chootka/sLLM/documentation/exhibit_object.md

# Exhibition object — WYSIWYG

The piece as a thing that ships: a sealed Raspberry Pi and touch screen
playing one recorded run of the organism. Written 2026-09-02, touch panel and
hardware settled 2026-09-01.

## Plain English

The artwork is a circuit that a slime mould plays. The organism itself cannot
be sold or shipped, and neither can the rig it grew in, so what the buyer
receives is the instrument and one full day of the organism's activity, frozen
into a file. Plug it in and it plays that day, in real time, forever, from the
hours before the organism reached the first electrode to the hours after it was
taken out.

The screen is a touch panel, and it has exactly two things on it to touch:
one starts the sound, one opens a plain-language note about what is being
heard. Nothing else responds to a touch.

Nothing in the box is alive and nothing in the box needs a network.

## What ships

| | |
|---|---|
| form | sealed unit: Raspberry Pi 4, touch panel, DAC to stereo out, enclosure |
| behaviour | powers on, boots into the piece. Two touch targets, nothing else |
| touch | `SOUND ON/OFF` top right, `SOUND LOG` top left. 56 px minimum targets |
| content | `exhibit/object/` -- page, worklet, recording, synth, static server |
| audio | a node process, not the browser. See below |
| size on disk | 4.0 MB |
| network | none required at any point |
| writes | none at runtime |

## The recording that ships

Run 8, exported by `scripts/export_replay.py` from the electrode CSVs. The
signal chain runs once at export time; the object replays the result.

| | |
|---|---|
| length | 62.5 h |
| loop | 5.2 hours, one pass, at `?speed=12` |
| ch0 | 33.6% |
| ch1 | 77.5% |
| ch2 | 35.1% |
| file | `exhibit/replay.json`, 3.4 MB, signal per second, gate as index runs, period per minute |

Three windows end to end, all of them recordings in which the organism was in
the dish:

| | window | what happens |
|---|---|---|
| A | 2026-08-24 05:00 - 08-25 00:35, 19.6 h | silence, then ch1 arrives at h+9.4 |
| B | 2026-08-25 06:05 - 08-26 04:00, 21.9 h | ch1 and ch2 both driving |
| C | 2026-08-28 03:00 - 08-29 00:00, 21.0 h | ch0 driving, ch1 in and out |

What a listener passes through, in loop time: nine hours of three uncoupled
voices with nothing on any electrode, a first pin arriving, ten hours of one
voice pulling, a second pin arriving and the ring beginning to couple, twenty
hours of both, then the pair falling away as a different electrode picks up and
carries the last twenty hours on its own. Then it begins again.

**Why these three and not the whole record.** Every window in which the rig was
handled is left out -- the lid coming off on 2026-08-26 at 04:05, the camera
ribbon being reseated, both `sllm-api` restarts. Those register as several mV
against a 1.7 mV baseline and would be the loudest events in the piece, and
they are the sound of a person, not an organism. Segment A stops and B resumes
around 2026-08-25 00:35-06:05 for a different reason: ch0 gates there, and ch0
was never colonised in run 6, so those are the cross-talk false positives
`signal_processing.md` documents. Sonifying them would drive a vactrol from a
connection that did not exist.

The joins land on gate changes, so they read as a pin arriving or dropping
rather than as an edit.

## Touch

The object has no pointer, no keyboard and no one to help a visitor who gets
lost, so the page behaves differently when it is running as the object than it
does on the website. `Drift.vue` decides which it is from the presence of the
bundled recording -- the thing that is actually true about the object -- rather
than from a flag on the kiosk URL that could be left off. `?kiosk=1` forces
that behaviour on a laptop for previewing.

| | website | object |
|---|---|---|
| tap the field | toggles fullscreen | does nothing |
| back to the dashboard | present | not rendered |
| cursor | arrow | hidden |
| target size | 27 px | 56 px minimum, larger type |

Three of those are load-bearing:

- **A tap on the field must not toggle fullscreen.** Under kiosk the object is
  already fullscreen, so the only thing a stray tap could do is take it *out*,
  and nothing in the box could put it back.
- **The dashboard link has to go.** There is no API behind it on the object, so
  a tap in the corner would strand a visitor on a broken page with no route
  home.
- **Targets are sized for a finger.** The web sizes are 27 px tall and rely on
  `:hover`, which never fires on glass. The touch sizes are keyed to
  `@media (pointer: coarse)`, so they follow the input device rather than
  object mode, and `:active` gives the only feedback a finger gets that the tap
  landed.

The field also sets `touch-action: manipulation` and suppresses text selection,
the long-press callout and the tap highlight. Without those a finger gets
double-tap zoom, a selection drag across the field, and a context menu, none of
which a sealed object can recover from.

**The object boots silent, by design.** Sound starts on the first touch of
`SOUND ON`, not at power-on. Two consequences to weigh before a show: a visitor
who turns the sound off leaves it off for the next person, and an untouched
object reads as a still image rather than a piece with sound. If either matters
at a given venue, the fixes are an autostart on load and an idle timer that
restores sound and closes the log. Neither is built.

## How the sound is shaped

Settled 2026-09-03. Circuit fidelity is no longer the tiebreaker for this
object -- these are aesthetic choices, judged by ear. What stays fixed is that
the sound follows the recording: nothing here is keyed to anything but the data.

- **The bed and the foreground.** With no pin connected there is no bio signal,
  only the oscillators idling, and hours of that at full brightness is
  genuinely wearing -- nauseating, in the artist's word. The piece now rests as
  a pad and comes forward when the organism reaches an electrode. The swell is
  keyed to the vactrol drive, so it follows whatever the data does rather than
  any assumption about which pin connects when.
- **Measure contact above the free-run floor.** The drive rests at 0.12, not 0.
  Keying the swell to the raw value made "rest" compute a third of the way
  open, and every attempt to tune the bed fought that instead of the sound.
- **The pad comes from the capacitor node, not the comparator.** A 40106's
  output is a hard square: instantaneous edges, which alias at 48 kHz, and
  aliased partials fold down *below* the cutoff where no filter reaches them.
  That inharmonic content is why filtering only ever made the bed duller
  without making it smoother. The capacitor voltage ramps between the two
  Schmitt thresholds -- a triangle, with almost nothing to alias. Some square
  blends back as contact arrives, where the bite belongs.
- **Register: `capScale` is 1.0, not 2.13.** At 2.13 the bank runs at 35-67 Hz.
  That was audible only because a square's harmonics reach into the hundreds of
  Hz; once the triangle and the low-pass removed them, 94% of the output energy
  sat below 60 Hz and the piece went silent on ordinary speakers. Measured, not
  guessed -- and the trap is that RMS still reads healthy, so it is possible to
  make the piece twice as loud and completely inaudible at the same time.
  **Check where the energy is, not just how much.** Render offline and look:

        node synth.js --wav /tmp/t.wav --secs 8 --speed 12

- **Levels live in `synth.js`, not the worklet.** The host posts `gain`, `vco`,
  `mix` and `capScale` at startup and they overwrite the processor's own
  defaults. Editing the constructor alone does nothing.
- **A brown-noise layer was tried and removed.** Brown noise is road noise --
  it read as scrapy, then noisy, then "inside a car on the freeway". Left wired
  at zero (`NOISE_LEVEL`) in case a trace sits well under a fuller pad later.
- **Long vactrol tails.** 5 ms rise and 50 ms fall passed every wobble in the
  data straight to pitch, which is what made this restless rather than
  hypnotic. 50 ms/600 ms is both calmer and closer to a real LDR.
- **The bed is stereo.** Fading the PLL in with contact left the right channel
  silent between connections -- half the piece missing on a stereo pair, and
  most of why it once seemed too quiet. The split still means something where
  it matters: the left keeps the oscillators, the right hands over to the PLL.
- **The bloom and the swell are one gesture.** `FLASH_MS` in `Drift.vue` and
  `SWELL_UP` in `ring-processor.js` are both 1.5 s on purpose: the yellow
  travels out from the pin over exactly the time the sound takes to come
  forward. Change one and change the other, or they read as two events that
  happen to coincide.
- **Sound off puts the field in standby.** The synth keeps running, but nothing
  drives the picture, so only the slow rotation remains and blooms are
  suppressed. The object rests until a visitor starts it.

The numbers to turn, all at the top of `ring-processor.js`: `REST_LEVEL` how
far back the bed sits, `FC_BED` muffled versus piercing, `BED_DRIVE` thickness,
`TRI_FWD` how much bite the foreground keeps, `SWELL_UP`/`SWELL_DN` how it
arrives and leaves, `BED_DROP` bed register.

## The audio does not run in the browser

Chromium on this Pi cannot hold an audio stream. This was established by
bisection, not inference:

- A native `OscillatorNode` -- no JavaScript anywhere in the audio path --
  drives the ALSA device into repeated `XRUN` and `SETUP` exactly as the piece
  does. So does a worklet emitting pure zeros.
- `aplay` writing a five-minute tone to the same DAC is clean throughout.
- It ignores `/etc/asound.conf` and `PULSE_SERVER` and takes the hardware
  directly, so it cannot be moved onto a gentler path.

`SETUP` is the device being closed and reopened, and that reopen is what was
audible as clicking.

So `exhibit/synth/synth.js` runs the audio instead. It loads the **same**
`ring-processor.js` against the **same** `replay.json` and pipes PCM into
`aplay`. The worklet is never copied -- one file, so the browser and the object
cannot drift into two different instruments.

It publishes its state over Server-Sent Events on port 8081, and the page reads
that instead of running an `AudioContext`: oscillator frequencies, coherence,
mux address, drives, gates, and the pin-connect flashes. Audio and image now
come off one clock rather than two, which is better sync than the browser
version had. `SOUND ON` becomes a request to the synth.

Absent the synth, the page falls back to its own worklet unchanged, so
`sllm.visceral.systems/drift` is untouched by any of this.

**Feeding aplay correctly is the whole trick**, and getting it wrong sounds
exactly like the browser problem it replaced:

- Write in chunks. 128-frame blocks are 512 bytes and thousands of syscalls a
  second; 32 blocks is 85 ms per write.
- Let the pipe pace it. An extra wall-clock throttle stops the feed while the
  pipe would still take more, and aplay starves.
- Give aplay a buffer. `--buffer-size=32768` is 680 ms to coast on; the default
  is far too small.

Underruns are the symptom, and they are visible:

    journalctl -u drift-synth --since "10 min ago" | grep -c underrun

Zero is correct. Anything else and the piece is blipping.

## Build

    # three windows, then joined end to end
    ./scripts/py scripts/export_replay.py --start '2026-08-24 05:00:00' \
        --end '2026-08-25 00:35:00' --out /tmp/seg_A.json
    ./scripts/py scripts/export_replay.py --start '2026-08-25 06:05:00' \
        --end '2026-08-26 04:00:00' --out /tmp/seg_B.json
    ./scripts/py scripts/export_replay.py --start '2026-08-28 03:00:00' \
        --end '2026-08-29 00:00:00' --out /tmp/seg_C.json
    ./scripts/py scripts/splice_replay.py /tmp/seg_A.json /tmp/seg_B.json \
        /tmp/seg_C.json --out exhibit/replay.json --note '...'
    ./exhibit/build.sh                      # -> exhibit/object/
    python3 exhibit/object/serve.py 8080    # test at /drift

`replay.json` is checked for shape, not for status code, so a server that
answers every path with `index.html` cannot fool the page into thinking it has
a recording. With no `replay.json` present the same build runs live against the
API, which is what `sllm.visceral.systems/drift` does.

## On the object

1. Copy `exhibit/object/` to `/home/chootka/drift` on the Pi.
2. All three units to `/etc/systemd/system/`, then enable:

        sudo cp exhibit/drift-server.service exhibit/drift-synth.service \
                exhibit/drift-kiosk.service /etc/systemd/system/
        sudo systemctl daemon-reload
        sudo systemctl enable --now seatd drift-server drift-synth drift-kiosk

   `drift-synth` runs under `SCHED_FIFO` -- the real-time priority chromium
   never had. Priority 10, not 99: enough to beat the renderer, low enough that
   a runaway loop cannot lock the machine out of ssh.

3. Stop getty owning the console, or cage can never take it:

        sudo systemctl disable --now getty@tty1

   Without this the kiosk unit starts, exits cleanly with no error output, and
   restarts forever while the display sits on a login prompt.
4. Screen blanking off (`sudo raspi-config nonint do_blanking 1`), and set the
   timezone (`sudo timedatectl set-timezone Europe/Berlin`) -- the panel prints
   the recording's date in the object's own timezone.
5. Set the volume and store it. There are no controls on a sealed object, so
   whatever is stored is what the buyer gets on power-up. `Digital` at 85% was
   right on the HiFiBerry DAC+ Pro with powered speakers:

        amixer -c 0 sset Digital 85%
        sudo alsactl store
6. Check it survives a power cut, which is the thing a buyer will actually do:
   `sudo reboot`, and the piece should come back on its own with sound
   available on the first touch.
5. Make the DAC the default ALSA output and prove it before sealing: `aplay -l`
   to find the card, set it in `/etc/asound.conf`, then `speaker-test -c2
   -twav` to hear both channels come out of the actual speakers.
6. Touch the two buttons on the assembled object before it ships. Everything
   above can be right while the panel is still delivering no touch events.

Every flag in `drift-kiosk.desktop` is there for a reason, and the reasons are
written in the file itself. The four that will cost a show if they are dropped:

- `--autoplay-policy=no-user-gesture-required`. The visitor's touch on
  `SOUND ON` is a real gesture, so this is belt and braces rather than the only
  thing holding the sound up -- but Chromium can still refuse a first
  AudioContext on a page it thinks has had no genuine interaction, and the
  failure mode is a piece that looks fine and makes no sound.
- `--disable-session-crashed-bubble` and `--restore-last-session=false`. The
  buyer unplugs it; without these the next boot puts a "Chromium didn't shut
  down correctly" bar across the top of the artwork, and there is no keyboard
  in the box to dismiss it.
- `--disable-pinch` and `--overscroll-history-navigation=0`. A two-finger
  stray zooms the field, and a horizontal swipe navigates the page away.
- `--check-for-update-interval=31536000`. A Chromium update prompt over the
  field is the one piece of platform infrastructure the work does not need.

## Raspberry Pi OS Lite

The object runs Lite, which ships no browser, no display server and no audio.
Three packages cover it:

    sudo apt install -y chromium cage seatd pipewire pipewire-pulse wireplumber
    sudo systemctl enable --now seatd
    sudo usermod -aG _seatd,video,input,render chootka   # then log out and in

`cage` is a kiosk Wayland compositor: it runs one fullscreen app straight from
a TTY with no desktop behind it. `seatd` is what lets it take a seat when the
session is not on the physical console -- without it cage fails with
"Could not open target tty: Permission denied", and the `_seatd` group does not
exist until the package is installed.

Trixie calls the browser `chromium`, not `chromium-browser`. Running it by
hand, to check before enabling autostart:

    python3 ~/sLLM/exhibit/object/serve.py 8080 &
    cage -- chromium --kiosk --autoplay-policy=no-user-gesture-required \
        'http://127.0.0.1:8080/drift?speed=12'

Autostart is `exhibit/drift-kiosk.service`, which replaced the old
`drift-kiosk.desktop` -- Lite has no desktop session and no `~/.config/autostart`
to put a .desktop file in. It runs cage on tty1 through a real login session,
which is what lets it take seat0.

## Hardware

Settled 2026-09-01: **Raspberry Pi 4, touch panel, DAC for audio out.** Still
to be confirmed against the parts once they are in hand.

- **The DAC overlay must be `hifiberry-dacplus-std`.** Not `-pro`, and not
  plain `hifiberry-dacplus`. The board is an Innomaker PCM5122 HAT, 384 kHz/
  32-bit, with its own dual oscillators. The `snd_rpi_hifiberry_dacplus` driver
  auto-detects that Pro hardware and takes the board as clock master, then
  divides HiFiBerry's 22.5792/24.576 MHz crystals to get the sample rate.
  Innomaker fitted a different pair, so the driver programmed a divider for
  48000 and the card emitted 96000: **exactly double, and invisible to every
  layer above it.** `hw_params` reported `rate: 48000` throughout. `-std`
  forces the Pi to supply the clock and the rate comes out right.

  **The tell is the card name.** `aplay -l` must read `HiFiBerry DAC+`. If it
  reads `HiFiBerry DAC+ Pro`, the driver is dividing the wrong crystals and
  everything below follows. Note that plain `hifiberry-dacplus` also
  auto-detects Pro -- only `-std` reliably suppresses it.

  **The test, which takes fifteen seconds** (found 2026-09-03):

        head -c 1920000 /dev/zero > ~/10s.raw   # ten seconds at 48k stereo
        time aplay -D plughw:0,0 -f S16_LE -r 48000 -c 2 -t raw ~/10s.raw

  Must return ~10 s. It returned 5.09 s under `-pro`, reproducible to 4 ms.
  Re-run it after any change to the audio hardware, kernel, or OS image.

  What the doubling caused, none of which pointed at a clock: audio an octave
  high (the "chipmunk voice", which was never actually fixed, only lived with);
  `aplay` draining the synth's stream at 2x realtime so generated audio outran
  the wall clock a second per second; the state timeline hitting its 4000-entry
  cap after ~2.5 minutes and discarding the snapshots that matched audible
  audio; and the visuals desyncing from the sound at that exact moment, every
  run. Hours went into the desync as a software problem before the byte counter
  in `synth.js` and the `aplay` timing test located it in the hardware.

  Dead ends, recorded so they are not re-run: the ALSA software path (`hw:0,0`
  times identically to `plughw:0,0`), HAT EEPROM auto-configuration
  (`/proc/device-tree/hat/` does not exist on this board), short input files,
  and buffering (`buffer_size` is 24000 frames, half a second, far too small to
  explain a five-second discrepancy).
- **Audio out.** The DAC decides this, not the Pi. A Pi 4 does have the 3.5 mm
  jack, but the DAC is the better path and it has to be made the *default*
  ALSA device -- Chromium plays to whatever ALSA hands it, so a DAC that is
  present but not default is a silent object with no error anywhere to explain
  it.
- **Screen.** Any HDMI or DSI touch panel. The field is a character grid and
  rescales to whatever it is given. Confirm the panel reports as a touch device
  to Chromium; `--touch-events=enabled` in the launcher forces it on for the
  case where the panel enumerates after the browser starts.
- **Power cycling.** The buyer will unplug it. The launcher now suppresses the
  "Chromium didn't shut down correctly" restore bar, which would otherwise sit
  across the top of the artwork with no keyboard to dismiss it. A read-only
  overlay filesystem is still worth doing; nothing at runtime writes to disk.
- **Stereo, not mono.** The three oscillator voices come out of the left
  channel and the PLL out of the right. Measured on the built object: left peak
  0.25, right 0.04. The sound log describes that split to the viewer in so many
  words, so a mono DAC or a single speaker makes the piece contradict its own
  wall text.

## Playback

`?speed=` on the kiosk URL timelapses the file without a rebuild, and the
shipped kiosk URL carries `?speed=12`, which plays the 62.5 h in 5.2 hours.
Drop the parameter and the same file runs in real time, which is two and a half
days a pass.

5.2 hours is chosen so that nobody in a gallery hears it repeat, and so that
whoever owns it keeps finding parts of it they have not heard. The panel's first line states which is running.

The date on that line is rendered in the *viewer's* timezone, so it reads
"August 28" on a Pi set to CEST and "August 27" on a machine in the Americas.
Set the object's timezone before it ships.

**`speed` does not mean the same thing on the website as it does here**, and
the two differ by a factor of five for this window. `advance()` steps `speed`
*array indices* per second, and the arrays are built differently:

| | array | one index is | `speed=12` gives |
|---|---|---|---|
| website | `buckets = min(2000, span)` from the API | 5.4 s of record, for a 3 h window | ~65x real time, a pass every 2.8 min |
| object | `replay.json`, 1 Hz | 1 s of record, always | a true 12x, a pass every 15 min |

So a `speed` that sounded right on `sllm.visceral.systems/drift` is not the
same tempo once the window is frozen, and the object's is the honest one --
the label's "15 minutes" is true here and wrong on the website, where the
bucketing is not accounted for. 12 was chosen on the object after hearing both.

## Not in the box

No organism, no agar, no electrodes, no rig. The work is the instrument and the
record. The organism this record came from was removed from the dish on
2026-08-29 and is not part of the sale.

## Draft listing

**Title.** drift — a slime mould plays a CMOS circuit (sealed player, 5-hour cycle)

**Spec.**

- Sealed player: Raspberry Pi, touch screen, stereo audio out. Plug in and it
  runs. Two things to touch: one starts the sound, one explains what you are
  hearing.
- Plays 62.5 hours of recorded *Physarum polycephalum* activity on a 5-hour cycle.
- Sound and image are generated live from that recording by a software model of
  a CMOS oscillator circuit, not video playback.
- No network, no account, no app, no writes. It runs the same in fifty years as
  it does now, given power.

**Description.** Three metal electrodes sit in agar in a covered dish. A slime
mould is placed on a fourth and grows outward. When it reaches an electrode, a
voltage appears there that rises and falls about every two minutes. This was
recorded once a second for a day and a night, from before the organism arrived
at the first electrode to after it was taken out.

Those measurements drive three oscillators wired in a circle, each leaning on
the next. Pushed hard they collapse into one note; released they slide apart
and beat. The picture is the same three oscillators drawn as interference
rings. It is not a rendering of the data; it is the data pushing a circuit
around.

The recording is dated and specific: 62.5 hours drawn from late August 2026.
It opens before the organism has reached anything, and over the cycle two
electrodes are reached, held, and lost, and a third picks up. Five hours of
playing time, then it begins again.
