chootka/sLLM/documentation/archive/session_20260824.md

# 2026-08-24 — steps 1-4 closed, live run started

Session: 2026-08-24, 01:34-03:00 CEST (Pi clock, Europe/Berlin).
All timestamps in this document are CEST unless marked otherwise.

## Step 1 — shorted-lead test. DONE

*Recorded 2026-08-24 01:34:49-02:01 CEST.*

Four rows tied with wire scraps (r38L, r38R, r40L, r40R). Resistor legs are
trimmed flush; nothing to clip. Recorded 27 min, 1511 samples, 8 SPS.

| | shorted | settled beaker |
|---|---|---|
| ch0 | -1.72 | -3.71 |
| ch1 | -1.45 | -3.77 |
| ch2 | -2.32 | -4.01 |

Drift over 27 min: ch0 +0.025, ch1 +0.004, ch2 +0.031 mV. Flat.

Electrode contribution (beaker minus shorted): ch0 -1.99, ch1 -2.32, ch2 -1.69 mV.

Inter-channel spread is smaller in solution than shorted (ch2-ch0: -0.600 shorted,
-0.299 in beaker). Electrode offsets partly cancel op-amp offsets.

Offsets do not matter: stable to 0.053 mV across the settled hours, and the
buffers are unity gain so amplitudes stay comparable between channels.

**Withdrawn:** the "ch2 wanders 2.7 mV / 20 min" claim. It came from a 20 min
window taken ~50 min after immersion, inside the settling transient. The 26 h
beaker record (78,609 samples, 2026-08-22 02:00 -> 2026-08-23 04:04) shows all
three converging to within 0.35 mV and flattening. No re-plating.

Method: do not attribute drift from a window shorter than the settling time.

## Step 2 — foil shield. OPTIONAL, not indicated

*Decided 2026-08-24 ~02:15 CEST, from data of 2026-08-22/23 and 2026-08-24.*

High-frequency noise, sample-to-sample, drift-immune:

| | shorted | in beaker |
|---|---|---|
| ch0 | 0.037 | 0.026 mV |
| ch1 | 0.020 | 0.026 mV |
| ch2 | 0.182 | 0.060 mV |

In-solution noise is at or below the shorted floor, so the chamber is not
picking up. No day/night pattern across 26 h (ch2 0.040-0.096 mV). ADS1115 at
8 SPS already notches 50/60 Hz.

ch2's excess noise belongs to the wire-scrap tie, not the channel.

## Steps 3-4 — agar islands. DONE

*Built 2026-08-24 ~02:15-02:40 CEST.*

Four non-nutrient 2% islands, bare dish floor between, 150 mm arena.

| | diameter | height |
|---|---|---|
| reference, centre | 20 mm | 4 mm |
| recording x3 | 15 mm | 4 mm |

10 mm bare floor edge-to-edge. Centre-to-recorder 27.5 mm.

As built: two recording islands 10 mm from each other and from the reference;
the third 10 mm from the reference only. Acceptable — each channel is E - REF,
so the reference distance is what sets it. The close pair is a short-baseline
comparison.

Tips flat on the dish floor at one depth, agar dropped over them. Oat flake on
the three recording islands, none on the reference.

**Expected period is 30-40 min, not 60-200 s.** 27.5 mm spacing is the 2-3 cm
band (Adamatzky and Jones 2011). The 60-180 s figure (Kishimoto 1958) needs
2-3 mm spacing, which is incompatible with 10 mm gaps. Gaps kept: the chamber
runs 95-97% RH and condensation bridges narrow bare plastic.

## Order changed

Organism was inoculated before step 5 (12 h blank noise floor). Not reversed.
Step 5 is dropped; step 7 (post-removal blank) extends from 6 h to 12 h and
serves as the only blank. Interpretation now happens before the control instead
of after.

## Run state

*As of 2026-08-24 02:42 CEST.*

- `20260824T004220Z-live` started 02:42 CEST, writing
  `data/readings/electrodes_20260824.csv`
- Recovery mode ON — panel dark, blue/red LEDs blocked, `sllm-loop` held off
- Timelapse running, 300 s interval
- 24 h counts from when a tube bridges to a recording island, 36 h max
- Then: organism out, `test` mode, 12 h blank

## Notes

- `data/readings/test/electrodes_20260823.csv` carries 2071 NUL bytes from the
  unclean shutdown at 2026-08-23 04:04. Three lines lost of 77,479. Skip lines
  containing NUL when parsing.
- Admin `POST /api/admin/run` returns 401 when not logged in. The mode switch
  silently does not take.

## For the paper

Rationale and citations: `method_basis.md`.

### Methods as built, as of 2026-08-24

Instrumentation. Four Ag/AgCl electrodes, tips chloridized electrolytically over
5 mm. One MCP604 CMOS quad op-amp as unity-gain follower per electrode, VDD 3V3,
inputs biased to 1.65 V through 10 MΩ. 10 kΩ + 100 nF at each ADC pin, low-pass
159 Hz. ADS1115 16-bit ADC at 8 SPS, which notches 50 and 60 Hz. Recorded
differentially as E - REF, three channels against one shared reference. Raspberry
Pi 5. Electrodes enter on shielded Cat6 through a sealed grommet with a drip
loop; shield grounded at the board only, never inside the chamber.

Arena. 150 mm Petri dish in a plain plastic chamber, 25 C, 95-97% RH. Four
islands of non-nutrient 2% agar on the bare dish floor: reference 20 mm dia x
4 mm, three recording islands 15 mm dia x 4 mm, 10 mm of bare floor edge to
edge, 27.5 mm centre to centre. All four tips laid flat on the dish floor at one
depth and agar dropped over them. Bare oat flake on each recording island, none
on the reference. Plasmodium inoculated on the reference island. LEDs off, panel
held dark, timelapse at 300 s.

Departures from Adamatzky and Jones 2011: 150 mm arena rather than 90 mm; three
recording electrodes rather than up to eight; discrete islands separated by
10 mm of bare floor rather than blobs at unstated spacing.

### Instrument characterization — citable

*Measured 2026-08-24 01:34:49-02:01 CEST.*

Measured with electrodes removed and the four buffer inputs tied into one node,
27 min at 8 SPS:

| | drift over 27 min | HF noise, shorted | HF noise, in solution |
|---|---|---|---|
| ch0 | +0.025 mV | 0.037 mV | 0.026 mV |
| ch1 | +0.004 mV | 0.020 mV | 0.026 mV |
| ch2 | +0.031 mV | 0.182 mV | 0.060 mV |

HF noise is the standard deviation of the sample-to-sample difference divided by
sqrt(2), which is immune to slow drift. In-solution noise at or below the
shorted floor demonstrates the chamber picks up no significant interference; no
electrical shielding was fitted. No day/night pattern over 26 h (ch2
0.040-0.096 mV).

Fixed inter-channel offsets 0.2-0.9 mV, stable to 0.053 mV over the settled
hours. Buffers are unity gain, so amplitudes are comparable across channels.

Against the 2-5 mV amplitudes reported by Adamatzky and Jones, signal to noise
is 50-200x.

### Negative results worth reporting

1. A 20 min recording taken 50 min after immersion showed 2.7 mV of apparent
   drift on ch2. A 26 h record showed all three channels converging to within
   0.35 mV. The apparent drift was the settling transient. Drift must not be
   attributed from a window shorter than the settling time.
2. An earlier ~50 s rhythm was an artifact of common-mode subtraction against
   the shared reference, not biological. Signals appearing identically on all
   three channels indicate reference movement.
3. The continuous agar bed used previously shunts the source. Computed divider
   30:1 to 300:1; a 5 mV tube potential arrives as 17-170 µV.

### Protocol deviation this run

The 12 h blank noise floor was scheduled before inoculation. The organism was
introduced first. The blank is therefore recorded after organism removal rather
than before. Same measurement, opposite order; interpretation precedes the
control.

## Timeline, 2026-08-24 (CEST)

| time | event |
|---|---|
| 01:34 | Pi booted after power loss; API up; test run resumed |
| 01:34:49 | shorted-lead recording starts, four rows tied |
| 02:01 | shorted-lead recording ends, 27 min, 1511 samples |
| 02:08 | electrodes untied and returned to saline; handling transient in record |
| ~02:15 | foil shield marked optional; agar island build starts |
| ~02:40 | four islands built, tips placed, plasmodium inoculated on reference |
| 02:38:53 | mode switch to live rejected, HTTP 401, admin not logged in |
| 02:42:20 | live run `20260824T004220Z-live` starts recording |
| 13:24:30 | tube bridges reference to ch1 (blue). ch1 steps +18 mV vs ch0/ch2, all three step +19 mV common mode, ch1 per-sample noise falls 6x |
| 23:15:30 | second tube bridges to ch2. ch0 and ch2 step, ch1 flat. ch2 noise falls 6.5x (0.703 -> 0.108 mV) over the following 20 min. ch0 noise unchanged, so not a condensation film |

Prior record referenced: beaker settling run 2026-08-22 02:00 to 2026-08-23
04:04 CEST, 78,609 samples. Power lost 2026-08-23 04:04; Pi off until
2026-08-24 01:34.

Expected next: 24 h from tube bridge, 36 h max, then organism out and 12 h blank
in test mode. Bridge 13:24:30, so 24 h ends 2026-08-25 13:24 CEST, 36 h max 2026-08-26 01:24.

Document written 2026-08-24. `method_basis.md` written 2026-08-24.
