chootka/sLLM/documentation/archive/session_20260826.md

# Session 2026-08-26

Run `20260824T004220Z-live`, continuous since 2026-08-24 02:42 CEST. 49.4 h at
the time of writing. Hours below are relative to the first bridge,
2026-08-24 13:24:30 CEST.

Charts: https://claude.ai/code/artifact/c5d332ef-effc-4cc0-9f22-fe3fae29b3d0

## Channel map

Board A rows are the source of truth, confirmed at the bench 2026-08-26.

| ADS input | channel | Board A row | Cat6 pair | state |
|---|---|---|---|---|
| A0 | ch0 | r38L | orange | never colonised |
| A1 | ch1 | r40L | blue | bridged 08-24 13:24:30 |
| A2 | ch2 | r40R | green | bridged 08-24 23:15:30 |
| A3 | reference | r38R | brown | inoculated at t=0 |

`hardware_setup.md` had green and blue transposed ("orange E1, green E2,
blue E3"); corrected. Panel trace colour for ch0 changed from yellow (the ADS
lead colour) to orange (the Cat6 pair) in `frontend/src/App.vue` —
**source only, the deployed bundle still draws yellow until a rebuild.**

## Timeline additions

| time | event |
|---|---|
| 2026-08-26 04:05:30 - 04:07:00 CEST | lid opened, electrodes wiggled. Per-sample noise 4.1 mV (ch0), 4.8 mV (ch1). **Exclude this window from all analysis.** |
| 2026-08-26 04:07 onward | ch2 offset moved from -11.2 to -6.7 mV across the disturbance and did not return |
| as of 2026-08-26 | ch0 island still not colonised. Organism has not bridged to it. |
| 2026-08-26 ~04:14 | camera ribbon pulled while powered, then reseated. Frame sizes fell 250 kB -> 93 kB |
| 2026-08-26 04:18:36 | `Camera frontend has timed out!` in `sllm-api`. Captures stopped after 04:14:47; 04:19 and 04:24 missed |
| 2026-08-26 04:21 | raw probe: `i2ctransfer -f -y 11 w2@0x1a 0x00 0x16 r2` -> `0x07 0x08`, VCM 0x0c -> 0xf2. Sensor and focus motor both alive. I2C control pins fine, CSI data lanes not delivering |
| 2026-08-26 04:23:41 - 04:23:57 | **`sllm-api` restarted to recover the camera. 15 s gap in the electrode record.** run_id `20260824T004220Z-live` preserved, no new run started |
| 2026-08-26 04:23:46 | first frame after restart, 237 kB, sharp. Camera recovered. No hardware damage |

## Frontend

Rebuilt and deployed 2026-08-26 04:24. ch0 trace is now orange
(`#b4560e` light, `#ef9040` dark) instead of yellow. `/var/www/sllm/frontend`
carries `index-Cy_MKtRu.js`; the old `index-Tx28pMR8.js` is gone.

## Findings, technical

### 1. A 2.2-2.4 min oscillation is established on the bridged channels

Welch periodograms, 4 h Hann segments, 50% overlap. Significance from 200
coloured-noise surrogates drawn on each channel's own smoothed background
(running median, +-0.6 octave in log period).

| window | ch0 unbridged | ch1 bridged 13:24 | ch2 bridged 23:15 |
|---|---|---|---|
| blank h-10..-0.2 | 1.1 min, p 0.14 | 1.3 min, p 0.84 | 1.1 min, p 0.12 |
| plateau h+11..22 | 2.4 min, p 0.015 | 2.4 min, p <0.005 | 2.4 min, p <0.005 |
| decay h+23..end | 2.6 min, p 0.50 | 2.2 min, p <0.005 | 2.2 min, p <0.005 |
| latest h+26..38 | 2.18 min, p 0.36 | 2.22 min, p <0.005 | 2.22 min, p <0.005 |
| latest h+30..38 | 1.25 min, p 0.60 | 1.82 min, p <0.005 | 1.82 min, p <0.005 |

Amplitude, ch2: 1.05 mV at h+10, 1.81 mV at h+28, 0.67 mV at h+30..38.
Amplitude, ch1: 0.26-0.88 mV over the same span.
Period wanders 1.82-2.58 min across successive 4 h windows.

### 2. Controls passed

- **Chamber.** Temperature and humidity carry a line at 4.00 min only
  (0.0027 C, 0.0008 % RH). Nothing at 2.4 min.
- **Camera.** Timelapse interval 300.0 s. Epoch average of 132 captures at
  +-150 s: max |z| 2.7 (ch0), 1.8 (ch1), 1.4 (ch2) over 301 lags. No 300 s line
  in the ch2 spectrum (PSD ratio 0.45 to local median).
- **Shared reference.** Survives differencing. ch1-ch2 peaks 2.22 min at
  0.66 mV, excess +1.80 dex, p <0.005 at h+26..38.
- **Electrode connection.** Per-sample noise ch1 0.021-0.039 mV, ch2
  0.043-0.073 mV against 0.10-0.22 mV pre-bridge. ch0 unchanged at
  0.15-0.32 mV, consistent with it never having been bridged.

### 3. The 30-40 min band is still not established

0.23-0.47 mV against an expected 4-5 mV. 84% of post-bridge variance is common
to all three channels.

### 4. The DC excursion is the bridge transient, not the chamber

Step at each bridge, peak +28 mV at h+18/19, zero crossing at h+32/33.
Decay constants 8.6 h (ch0), 5.6 h (ch1), 6.5 h (ch2); slopes -1.4 to
-2.2 mV/h. Correlation with chamber temperature over h>10 is r = +0.04 to
+0.07; temperature rose 21.2 -> 25.2 C from h+28 to h+35 while all channels
fell. Correlation with elapsed time r = -0.88 to -0.91.

Inter-channel spread: 13 mV pre-bridge, 0.5 mV at h+24, 6.7 mV at h+35. Decay
rates differ per channel, so the cause is per-site, not the shared reference.

### 5. Literature match

`~/research/1012.1809v1.pdf`, Adamatzky and Jones, same electrode geometry
(one reference island, plasmodium inoculated on it, recording islands under
agar blobs):

- high-frequency waves 1-2 min at 2-3 mV -- this run: 2.2-2.4 min at
  0.5-1.8 mV. Match.
- Kashimoto, surface potential 5 mV at 1.5-2 min. Same family.
- main oscillation 30-40 min at 4-5 mV after an 8 h transient -- not seen.
- "potential rises from ground potential to 14 mV in 24 min, then drops to
  roughly -5 mV in around 37 min" as a site is occupied. Same shape as the DC
  excursion here, about 40x slower.

### 6. Method errors corrected this session

- **Raw band power ranked the wrong channel first.** ch0 has the highest raw
  1-2 min band power because it is the noisiest input (0.15-0.32 mV/sample
  against ch1's 0.02-0.04). Peak-above-local-background reverses the ranking
  and is the correct statistic.
- **Two band-amplitude estimators disagreed by 120x** before validation.
  Inject a known sinusoid and confirm recovery before trusting any estimator.
  Current one: 1.0 mV at 120 s -> 0.998; 0.5 at 1800 s -> 0.502; 4.0 at
  2100 s -> 4.000.
- **Phase-randomised surrogates are the wrong null** for a spectral peak; they
  preserve the periodogram exactly. Use coloured noise on the fitted
  background.
- `scripts/signal_check.py` searches PERIOD_MIN 30 s to PERIOD_MAX 240 s. That
  brackets this line, but its verdict needs a baseline file and was not used.

## Findings, plain language

A "band" is a range of rhythm speeds, the way bass and treble are ranges of
pitch. The millivolt figure is how big the voltage swing is at that speed.

1. The slime mould has reached two of the three recording islands. Those two
   electrodes show a voltage that rises and falls about every **2.2 minutes**,
   swinging up to **1.8 thousandths of a volt**. The third electrode, which the
   organism never reached, does not do this. Neither did any electrode before
   the organism arrived.
2. That rhythm is not coming from the equipment. The chamber's own rhythm is a
   different speed (4 minutes) and thousands of times smaller. The camera fires
   every 5 minutes and leaves no trace in the readings. Comparing the two
   colonised electrodes against each other, the rhythm is still there, so it is
   not one shared electrode moving everything at once.
3. The rhythm speed drifts between 1.8 and 2.6 minutes. Electronics keep near
   perfect time; living things do not. The drift is a point in favour of it
   being the organism.
4. The published work on this organism reports a fast rhythm of 1-2 minutes at
   2-3 thousandths of a volt. What is measured here is close to that.
5. The **half-hour rhythm the experiment was designed around is not there** --
   about a third of a thousandth of a volt where 4-5 was expected, roughly ten
   times too small. Only the fast rhythm is present.
6. The large swing from +28 down through zero to -6 thousandths of a volt is a
   separate thing and is not the organism's rhythm. It is the electrodes
   settling after the slime mould connected them, over about six hours per
   channel. It is not temperature: the chamber warmed up while the reading kept
   falling.

## Open

- Whether the 2.2 min line is contractile activity or electrochemistry at a
  colonised electrode. The organism-out blank in `test` mode decides it: if the
  line survives removal, it was never biological.
- The 30-40 min band, 10x under spec.
- ch0's marginal result, p 0.015 in one window and p 0.50 in the next.
- Why the DC potential relaxes past zero rather than back to its pre-bridge
  offsets.
- `rebuild_plan.md` step 5 states the artifact criterion as "a clean 60-200 s
  oscillation with no organism means artifact". The band is **correct** -- the
  signal is at 130-145 s, inside it. An earlier note calling for it to be
  restated for 30-40 min was based on the pre-2026-08-26 expectation and is
  withdrawn. Two real gaps remain:
  - "clean" is not a number. Fix the rule before running the blank, using the
    same statistics as the finding: a peak in 60-200 s exceeding local
    background by >1.0 dex at p<0.01 means artifact.
  - step 5 has never been run. Every blank used so far is the pre-bridge window
    inside run 6. That window is arguably better (same session, same chamber),
    but the plan should say so rather than leave the box unticked.
