chootka/sLLM/processing/phygraph/next.png

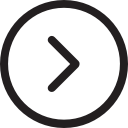
processing/phygraph/next.png
