chootka/sLLM/(commit log)

2025-11-15 Add deployment scripts for Raspberry Pi
2025-11-18 added processing, arduino scripts, updated project architecture, added dev python reqs for mac
2025-11-18 Fix Arduino reconnection logic - handle None check properly
    [app.py]
2025-11-18 Add system site-packages path for libgpiod on Raspberry Pi 5
2025-11-18 Add mock temperature/humidity data and multi-line chart with dual y-axes
    - Generate mock temp/humidity data when sensor not available
    - Update chart to show voltage, temperature, and humidity
    - Add dual y-axes (voltage on left, temp/humidity on right)
    - Fix environment thread to start even without sensor
    - Add proper chart legend and tooltips
    [app.py, config_template.py]
2025-11-18 Display voltage in millivolts (mV) instead of volts
    - Keep voltage in mV from Arduino (no conversion to V)
    - Update frontend display to show mV with 1 decimal place
    - Chart already updated to show mV
2025-11-18 Fix Flask-SocketIO production server error - add allow_unsafe_werkzeug=True
    [app.py]
2025-11-18 fixed Y axis; lighter label colors
2025-11-18 hiding light button, prep for using GPIO relay and usb module to control light; connected capture image button
2025-11-18 debuggin camera capture
2025-11-18 Make GPIO initialization more robust - handle missing relay gracefully
    [app.py]
2025-11-18 Fix image caching issue - add cache-busting headers and revoke old blob URLs
    [app.py]
2025-11-18 Update chart Y-axis range to -5 to 5 mV
2025-11-18 Fix image filename collision - add milliseconds to timestamp to prevent overwriting files
    [app.py]
2025-11-18 Fix image display: use server URLs instead of blob URLs, listen to socket events, add cache-busting
    [app.py]
2025-11-18 Update chart Y-axis range to -10 to 10 mV
2025-11-18 Reorganize UI: move Capture Image button to Visual Timeline, status indicator to top right, remove Controls section
2025-11-18 Ensure video renders at top on mobile devices
2025-11-18 Add live USB camera stream endpoint and replace still images with live feed
    [app.py]
2026-08-02 added llm dir with data filters
2026-08-05 Replace absent hardware with what is actually attached
    The API was driving hardware this machine does not have. Electrode readings
    came from an Arduino over serial with no Arduino plugged in, image capture
    went through OpenCV against a USB camera that is not there, and the
    temperature sensor had a DHT22 fallback for a sensor that is an SHT31. When
    the SHT31 could not be read the environment loop generated plausible
    temperature and humidity and published them, so the dashboard has been
    showing invented numbers for an unmeasured chamber. On an experiment that
    already runs sham blocks, fabricated environmental data is not a harmless
    placeholder.
    Hardware now lives in gpio/, one module per devi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
    [adc.py, app.py, bus.py, camera.py, config_template.py, leds.py, sensor.py]
2026-08-05 Add bring-up checklist for the replacement Pi and the camera
    Records the verified state of the new board, how to run each hardware module
    standalone, the CSI attach procedure, and the three options for the matrix
    root problem.
2026-08-05 Add the live model loop, on-disk logging, and a fast replay harness
    llm/loop.py closes the loop CLAUDE_README describes: reduce a 30 min window,
    POST to Ollama on the laptop, validate the action, apply it or deliberately
    withhold it, log the turn. It imports reduce_window and the prompts from
    llm/filters rather than copying them -- harness.py is meant to be evidence
    about what the live loop does, and it stops being that the moment the two
    implementations can drift.
    Two gaps had to be closed before any of it could run.
    Nothing was writing readings to disk. The rolling buffer is memory only and a
    restart emptied it, so a run that goes on for days -- the empty-chamber run
    alone is two to thre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
    [adc.py, app.py, camera.py, config_template.py, sensor.py, store.py, syspath.py]
2026-08-05 Deploy llm/ and scripts/ alongside the API
    The loop reads the CSV the service writes, under the deployment's data
    directory. Run from the checkout it resolves its own empty data directory and
    reports 0 samples, which is indistinguishable from a dead ADC.
2026-08-05 Rewrite README for current project vision
    The README described an earlier concept: a human chat interface that
    translated typed messages into stimuli and slime mould electrical
    responses back into natural language. The human has since stepped out
    of the loop.
    Reframes the project around the current instrument — a living analog
    core (Physarum in CMOS oscillator circuits) in recursive exchange with
    a language model, through sound as the shared medium. Documents
    llm/filters/ as the model-side measuring instrument, and states plainly
    what exists, what predates sLLM, and what is not yet built.
    Drops the stale roadmap and the roles section. Resolves the open
    question in the old text about what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
2026-08-05 Use "mould" spelling throughout
    Comments, docstrings, print output and documentation prose only. No
    identifiers, filenames or config keys touched.
2026-08-05 Fan: correct pins, hold PWM high, make air exchange the rule
    The fan exists to keep fresh air moving so mould does not establish. That is
    its only purpose; its effect on humidity and temperature is an accepted side
    effect, not a setpoint. FanController had this backwards, treating the RH
    deadband as the primary rule and the timed cycle as a fallback named
    floor_due. The timed cycle is now the whole rule, and RH is an optional
    extra-ventilation override that is off by default and can only ever add run
    time.
    Pins were wrong: the relay is on BCM 23 (physical 16), not the placeholder 22,
    and it is active-high. The fan's PWM line is BCM 12 (physical 32).
    The PWM pin has to be raised with the re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
    [config_template.py, sensor.py]
2026-08-05 bring_up: fan is wired and running, camera attached
2026-08-05 bring_up: live loop needs system python, not the venv
    Documented the venv form as the live command, which cannot drive the panel.
    Also records that python3-picamera2 and python3-numpy are now installed for
    the system interpreter, which is what lets one process run both the matrix and
    the camera -- previously no interpreter could, so the blank/flash capture
    sequence could not run at all.
2026-08-05 Root-owned matrix helper on a unix socket; frontend is a viewer again
    The panel needs root because rpi_ws281x goes through /dev/mem. The API must
    not be root because it is a Flask app reachable from the internet through
    nginx. gpio/matrixd.py is the seam: the only privileged process, a fixed
    vocabulary of eight commands over a unix socket at /run/sllm/matrix.sock,
    chowned root:chootka 0660, evaluating nothing a client sends.
    gpio/matrix_client.py presents the same methods as leds.Matrix, so app.py,
    camera.py and loop.py do not care which they hold. The API passes
    allow_direct=False: driving the panel in-process is exactly what is being
    refused. A live loop run no longer needs sudo at all.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
    [app.py, camera.py, matrix_client.py, matrixd.py]
2026-08-05 Add sllm-loop.service so the experiment has an on/off switch
    The model loop had no control surface: it ran only as a foreground command in
    an open terminal. It is now a service, and because matrixd owns the panel it
    runs unprivileged as chootka -- before the helper, a live run needed root.
    Not enabled at boot on purpose. The model driving light into a chamber should
    start because someone decided to, not because the power blinked. Restart is
    on-failure with a 60s delay and a rate limit rather than always: a loop
    restarting in a tight cycle would either spam the model or quietly become a
    permanent unlabelled sham, and a stopped loop is a visible problem where a
    flapping one is not.
    Two thing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
2026-08-06 Demo mode, chamber-occupied interlock, and a public turns endpoint
    loop.py --demo is the only mode that is both fast and actuating. It exists
    because there was otherwise no way to watch the hardware work: the live loop
    cannot be sped up without being made meaningless -- the 30 minute window and
    10 minute turn come from Physarum's contraction period, not from caution --
    and --replay, which is fast, deliberately refuses to drive the panel. Between
    them a zone changed once every ten minutes and that was the only way to see it.
    So --demo invents data and puts real light on the panel. What makes that safe
    is that it is loud, gated, and its turns go to data/logs/replay/ where they can
    never be mi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
2026-08-06 Add the /logs turn view, and demo + chamber controls in the admin panel
    /logs is its own route rather than a panel on the dashboard. No router library:
    nginx already serves index.html for any path, so matching window.location
    .pathname is the whole routing story. App.vue's mounted() returns early there --
    the chart has no canvas to attach to and the socket and image archive would be
    work for a view nobody is looking at.
    TurnLog polls /api/turns every 15s, requesting only what is new via ?after=,
    and keeps a follow-tail toggle. It shows the model's full note, the requested
    action, the reduced per-channel state, and any refusal.
    The SHAM and applied tags render only when the viewer holds an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
2026-08-06 Label every recording with the run it belongs to
    The rig records continuously and should not stop for a demo, a maintenance
    window, or the twenty minutes the lid is off -- holes punched in a 1 Hz series
    are harder to reason about afterwards than labelled stretches are. So nothing
    is withheld from the record. It is labelled, and analysis filters on the label.
    gpio/run.py holds the current run in data/run.json: {id, mode, started_at,
    note}. Modes are experiment, dev, demo and maintenance. Switching ends one run
    and appends it to data/runs.jsonl, which becomes the history of when the lid
    was open, when the organism was out, and when a demo was given -- exactly what
    you want a week later when a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
2026-08-06 Make demo mode actually watchable, and cut the modes to live/test/demo
    Demo was applying every turn correctly and was still impossible to see. Model
    latency is 25-35s, so turns land ~45s apart rather than the 10s the compressed
    interval implies, and holding a zone for 6 of those 45 seconds is a 13% duty
    cycle -- you had to be looking at the panel at the right moment, roughly once a
    minute. A quarter of the turns were also shams, which light nothing.
    Two fixes. In demo the zone now stays lit until the model picks the next one,
    so the panel always shows the current choice and visibly moves; and demo runs
    with --sham-rate 0, because a demonstration has nothing to control for and a
    sham turn ju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
    [run.py, store.py]
2026-08-06 Demo drives zones at full intensity; pill toggles throughout the panel
    The demo was applying every turn and was still invisible. STIM_BRIGHTNESS is
    0.25, so the model's typical 0.5-0.8 intensity lands around 31/255 -- only
    twice the always-on barrier, and easy to miss in a lit room. The sweeps that
    were visible earlier had all been at 1.0. A demo now drives whatever zone the
    model picked at full intensity: which zone it chose is the point, how brightly
    it asked for it is not.
    Modes cut to test and live. Recording, chamber, model loop and demo are all
    pill toggles now rather than pairs of buttons, and the chamber lost its
    explanatory paragraph.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
2026-08-06 Add documentation/next_session.md
    The blocking item is that the model's decisions have never been seen visibly
    lighting zones, in either live or demo form. That is the installation, not a
    presentation detail -- until it works there is no experiment, and it comes
    before the electrodes.
    The cause is unknown. All nine zones light individually through matrixd and the
    mapping provably tiles the panel exactly once, so the panel, daemon and mapping
    are not it. One demo-driven change was independently confirmed to the second;
    why the others were not visible is unexplained.
    The note records the experiment that has never been run cleanly -- demo going,
    everything else stopped, watched continuously f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
2026-08-08 Keep the panel showing what matrixd thinks it shows
    leds.Matrix only writes on a state change, so during a live run the panel
    is written once per ten minute turn. A frame that did not arrive intact
    therefore persisted for the whole turn, because nothing ever wrote again
    to correct it. Observed on the bench: matrixd held zone 6 for 41s while
    the panel went dark after ~15s, and zones 7 and 8 never appeared at all.
    The log said "applied" throughout, so a live turn could report a stimulus
    that never reached the organism.
    matrixd now re-sends the current frame every REFRESH_INTERVAL_S from the
    watchdog thread it already runs. The frame is identical, so no LED
    changes current and it creates none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
    [matrixd.py]
2026-08-08 Add a logs link and timelapse playback to the dashboard
    /logs already existed as a route but nothing on the dashboard pointed at
    it, so it was reachable only by typing the path. Plain href rather than a
    click handler: nginx serves index.html for any path, so the link works
    pasted, bookmarked or opened in a new tab.
    Timelapse could only be advanced by dragging the scrubber, which makes it
    hard to show the growth to anyone. A play button walks the frames at 5/sec;
    pressing it while parked on the last frame replays from the start.
    Two interactions the timer has to survive. A frame arriving from the
    backend timelapse mid-playback no longer yanks the position to the live
    end -- captures land ev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
2026-08-08 Preload timelapse frames before playing them
    Playback advanced every 200ms but each frame is a ~135KB JPEG fetched
    over the network, so the browser could not decode them as fast as the
    timer moved and playback sat on whatever frame was already there. Nothing
    after the starting frame was visible.
    Frames are now warmed into the browser cache before play starts, six at a
    time because browsers cap per-host connections around there anyway, with
    a "Loading frames n / total" readout and the button turning into a stop.
    Loaded URLs are remembered, so a second play is immediate.
2026-08-08 Let the browser cache captured images
    Timelapse playback showed the first frame and never advanced, while the
    scrubber worked and the img src demonstrably changed. The cause was not
    in the player: /api/images was served
    Cache-Control: no-cache, no-store, must-revalidate, max-age=0
    set both by the Flask handler and, with `always`, by a dedicated nginx
    location that overrode it. no-store forbids the browser from keeping the
    response at all, so every playback step was a fresh ~145KB download at
    five a second, and each new frame cancelled the one still in flight.
    Nothing after the first ever finished decoding. Scrubbing survived it
    because pausing on a frame gave one download time to land.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
2026-08-08 Make timelapse playback robust while diagnosing it
    Written while chasing what turned out to be a caching bug, but each stands
    on its own:
    - The playback timer sets currentImage itself instead of calling
    onTimelineScrub. setInterval swallows exceptions, so a throwing helper
    would advance the position while the picture stayed put, which is a
    hard failure to see.
    - A "Frame n / total" readout during playback. Added to tell whether the
    position was advancing independently of whether the image was; worth
    keeping, since it is the only feedback that playback is alive.
    - The livestream <img> gets an explicit key and the timelapse <img> is
    keyed per frame. Both branches of the v-if are <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
2026-08-08 Record when the light actually started and stopped
    The turn record is written while the stimulus is still on, so it can say
    what was asked for and never what happened. Duration was confirmed
    accurate today by stopwatch against a panel poll -- 30s requested, 30s
    delivered -- but that was a person standing in the room, which is not a
    measurement anyone can repeat later.
    apply_action now takes an on_switch callback and calls it when the zone
    is lit and again when the expiry timer clears it. Rows land in
    data/logs/switches_<day>.jsonl with epoch timestamps, replay and demo
    under replay/ like turns.
    The reason it is worth having: bus.SwitchGate keeps ADC conversions away
    from switching events i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
2026-08-08 Collapse chamber occupancy into the recording mode
    There were two controls on the admin panel asserting one fact. Recording
    test/live, and chamber empty/occupied, always moved together: live means a
    real session, which means something is in the chamber.
    Of the two, the mode is the one that stays accurate. Set it wrong and a
    real session is written to the test subdirectory where analysis filters it
    out, so it is corrected within a turn. The occupancy flag had no such
    consequence, so nothing forced it to be true -- and a safety flag that is
    allowed to go stale has already failed. The user made this point directly:
    if you can forget to click occupied, the guard was never load-bearing.
    So the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
    [admin.py, config_template.py]
2026-08-08 Refuse live recording while a demo is running
    Collapsing occupancy into the mode left a hole: `live` now asserts that
    something is in the chamber, but the demo interlock only runs at start, so
    switching to live mid-demo left invented light being driven onto a chamber
    that had just been declared occupied. Found by the user doing exactly that.
    The API refuses the switch with a 409 while the demo unit is active, and
    the button is disabled. The refusal is the guard -- the endpoint is
    reachable without the page.
    Refused rather than stopping the demo automatically: which of the two is
    wrong depends on whether the organism is actually in there yet, and only a
    person can see that. A panel going da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
    [admin.py]
2026-08-08 Cut the admin panel hints down
    Three sentences of rationale where one fact would do. The reasoning belongs
    in the code, not on a control someone reads while deciding what to click.
2026-08-08 Drop the redundant unit-state notice and dead setLoop
    Stopping demo printed "demo inactive." under a pill already showing
    stopped as the active side. setLoop was left behind when the template
    moved to setUnit for both units; nothing called it.
2026-08-08 Refuse demo while acquisition is live, instead of switching the mode
    Starting a demo used to switch acquisition to `test` first, so samples
    taken under invented light were routed away from the experiment record.
    That quietly defeated the interlock it appeared to support: loop.py
    refuses --demo while the mode is live, and the mode had already been
    changed by the time it looked, so the guard could never fire through the
    admin panel. The disabled button was the only thing left holding it, and
    the endpoint is reachable without the page.
    Now the API refuses with a 409, before the stop-the-other-unit step so a
    refusal cannot leave the model loop stopped for a demo that never started.
    The routing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
2026-08-12 Show all three electrode channels at a readable scale
    The panel looked dead but was reading the ADS1115 all along.
    - y axis -10..10mV flattened a sub-millivolt signal onto zero; now -5..5
    suggested, so it still expands for a real excursion
    - toFixed(1) rendered 0.031mV as "0.0"; now three decimals
    - only channel 0 was plotted; now one trace per ADC_CHANNELS entry
    - 0.5s emit against a 1Hz ADC duplicated every sample; deduped by timestamp
    - chart started blank; seeds from /api/readings/history
    - /api/config exposes adc_channels and adc_reference_channel for the labels
2026-08-12 Stop the deploy script from undoing the hardening
    Two things it did that would have regressed the box:
    - generated sllm-api.service from a heredoc with User=chootka and none of
    the hardening
    - copied etc/nginx.conf, the pre-reverse-proxy config, over the live site,
    removing the geo/map block the admin routes gate on
    Now:
    - deploy/ is the source of truth; units and nginx installed only when they
    differ, nginx -t before reload, no interactive prompt
    - restarts sllm-api only -- matrixd blanks the panel, the loop puts light in
    the chamber
    - adds --dry-run, --no-restart, --deps (pip is opt-in now)
    - deletes etc/nginx.conf and the two deploy docs that predate all of this
    - bring_up.md d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
2026-08-13 README: correct the hardware description against the build docs
    The enclosure and electronics paragraphs still described a rig that no longer
    exists: stackable compartmented boxes, an ADS1118 read by an Arduino, a macro
    camera, a ring light, a fish feeder. Rewritten from
    enclosure/physarum-chamber-layout.html and
    schematics/0_physarum-full-schematic.html: one sealed tub, electronics on an
    external backplane, MCP604 buffers into an ADS1115, 74AHCT125 driving the 16x16
    matrix, and the two rules about keeping switched current off the front end.
    Also: correct the tree listing (gpio/ and deploy/ were missing, etc/ no longer
    exists, arduino/ and processing/ marked legacy), document llm/loop.py, p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
2026-08-15 leds: recovery mode, and mask the imaging flash to the dish
    - RECOVERY blanks stimulus zones and drops the red backlight; set_zone is
    still accepted but records 0.0, so active_zones stays true to what the
    organism actually received
    - RECOVERY_DARK also drops the barrier, leaving the panel entirely dark.
    Blue is the band Physarum avoids most strongly, and the barrier guards
    against a journey a sclerotium cannot make yet
    - loop.py refuses live turns while RECOVERY is set, exiting 0 so
    sllm-loop (Restart=on-failure, and enabled) stops rather than retrying
    - imaging flash lights DISH_PIXELS only; the corner pixels backlit nothing
    and flared off the dish rim into the frame edge
    - matr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
    [leds.py, matrixd.py]
2026-08-15 camera: USB fallback and an admin source switch
    - open_camera returns a manager that can hold either a CSI or a UVC
    camera, so a dead ribbon no longer means no images at all
    - CAMERA_SOURCE picks one at startup; whatever the admin page last
    selected outranks it as the more recent statement of intent
    - /api/camera/sources and /api/camera/source, both behind the admin
    session and pinned to ADMIN_ORIGIN by path
    - MJPEG stream tolerates STREAM_MISS_LIMIT missing frames across a source
    change instead of ending and leaving the dashboard on a broken image
    - timelapse starts whether or not a camera is attached, and picks one up
    when it appears
    - separate USB resolution, JPEG quality and fl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
    [app.py, camera.py, config_template.py]
2026-08-15 dashboard: trace colours match the electrode leads
    - palette mirrors the physical lead colour of each channel, with the
    ADS input -> lead -> board row -> Cat6 pair chain in the comment
    - legend padding, so the swatches read as separate dots rather than one
    continuous strip
2026-08-20 Fix dominant_period reporting the edge of the search band
    - argmax over PERIOD_MIN..PERIOD_MAX always lands on the low edge for
    decaying noise, so the detector returned 30-32s on a third of
    unconnected-electrode windows and called it a measurement
    - require a trough then the FIRST peak after it; the first peak is the
    fundamental, the strongest is whichever slow bump is largest (~120s in
    the 2026-08-09 data, present with nothing connected)
    - gate on MIN_DEPTH, the peak's rise above that trough. Provisional at
    0.15 until a clean empty-dish baseline exists
    - 0/60 false positives on synthetic 1/f noise, against 74% before
    - add scripts/signal_check.py: turns a baseline recording into t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
2026-08-20 Add adversarial and mimic prompt variants, one prompt loader
    Both change loop behaviour, not only wording. A prompt describing a
    mechanism that is not wired is a prompt that lies to the model.
    adversarial - the organism consumes the model's context:
    - pins num_ctx, stops truncating history, sends compact state so a quiet
    channel drops its coarse trace (364 tokens active, 69 quiet)
    - reports remaining tokens each turn and stops when full, rather than
    letting Ollama evict the oldest turns
    - budget off our own conversation, not prompt_eval_count: that plateaus
    below num_ctx and never crosses, so the stop could never fire
    mimic - Physarum's architecture, not its vocabulary:
    - no conversa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
2026-08-20 Recovery mode, run labelling, and the bench scripts
    Uncommitted work predating this session, plus a comment pass over it.
    - gpio/recovery.py: runtime toggle in data/recovery.json, read on every
    render, owned by the admin page. Stimulus zones unrendered, captures
    without red, loop refuses a live run
    - gpio/store.py, gpio/camera.py: run_id and mode on every row, non-live
    modes to their own subdirectory
    - api/admin.py: recovery endpoints, demo/live interlocks
    - scripts/: electrode_health, electrode_settling, flatfield, focus_*,
    extract_skeleton, placeholder_skeleton
    - drop the resource field from the turn API; no such action exists
    - condense comments throughout: facts, units and const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
2026-08-20 Dashboard: range charts, timelapse, viz, dev banner
    Uncommitted work predating this session, plus a comment pass.
    - App.vue: live/range chart modes, time scale, autoscaled y axis,
    timelapse scrubbing with chamber overlay, theme-aware traces
    - traces coloured to match the physical electrode leads, dashed for
    greyscale and colour-blind readers
    - SlimeViz + viz/: skeleton territories per electrode, geodesic along
    the tubes, synthetic feed shaped off real readings
    - the page never drives a capture; it renders image_captured
    - "/// UNDER DEVELOPMENT ///" beside the masthead title
    - drop the resource display from TurnLog
2026-08-20 Docs: remove two stale files, correct the rest
    - delete CLAUDE_README.md: pre-build spec, wrong on the dish (150mm
    round, not 100mm square), the zone shapes, red as imaging light, and
    the matrix needing sudo. Listed adc/sensor/camera/loop as unbuilt
    - delete next_session.md: opened by calling the demo-cycling bug
    blocking, resolved 2026-08-08. Its two live items moved to bring_up
    - led_matrix.md showed the old nine-band zone map; regenerated from
    gpio/leds.py, and corrected STIM_BRIGHTNESS and IMAGING_BRIGHTNESS
    - bring_up.md: matrix section rewritten around matrixd, prompt variants
    documented, Still to build replaced with what is actually left
    - README: sensing logic and the syste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
2026-08-20 Add shape.py and a pre-registered growth run
    - shape.py plots the whole record before anything is computed. Both of
    2026-08-20's false findings were statistics over 30 min windows with
    nobody looking at the day; the plateau and the re-climb are obvious by
    eye. Carries min/max per bucket, which is how the +/-256mV rails at
    each dish change showed up
    - growth_run.md fixes the tests before the data exists. The organism
    grows and the chamber does not, so early-half against late-half is a
    control that needs no separate baseline
    - two of three tests must pass, with the humidity control not explaining
    them. One test alone is what failed twice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
2026-08-22 Record the 24h run: all tests negative
    - run 20260820T231556Z-live, 24h32m, 157 turns, 0 model failures
    - applied vs sham negative on all three channels, 111 v 28, best p 0.12
    - amplitude 1.07x early to late, identical across channels, so global
    - common mode is 0.96 of variance, up from 0.86
    - tests 2 and 3 not runnable: no baseline, and the IR imaging cannot
    segment the plasmodium
    - next step is the measurement, not more runs: true differential pairs
    on the ADS1115 reject common mode in hardware
2026-08-22 Set ADS1115 data rate to 8 SPS
    - data_rate was never set, so the library default 128 SPS applied
    - 125ms integration per conversion instead of 7.8ms
    - noise floor 0.7-2.8 mV sd -> 0.045-0.109 mV, measured on the same beaker
    - the excess was 50Hz aliasing through a window shorter than one mains cycle
    - ADC_DATA_RATE in config, alongside ADC_GAIN
    [adc.py, config_template.py]
2026-08-22 Delete eight dead scripts
    - checkout_livestream, diagnose_service, fix_service, monitor: no references,
    superseded by deploy_on_pi.sh
    - electrode_health, electrode_settling: infer tip impedance from ADS1115 input
    loading, which the unity-gain buffers block. They report on the buffers
    - focus_assist, focus_sweep: redundant with focus_meter
2026-08-22 Rewrite docs lean, correct hardware record, add rebuild plan
    Docs cut 1876 -> ~1100 lines. Narrative, rationale essays and prose
    changelogs removed; measured values, pins and commands kept.
    Corrections against the live system:
    - electrodes are Ag/AgCl, not aluminium tape
    - chamber is a plain plastic box, not foil-wrapped
    - sllm-api and sllm-loop run as sllm, not chootka
    - matrix socket is root:sllm 0660, not root:chootka
    - sllm-loop is enabled
    - Funnel is not the public path; traffic goes via the droplet
    - TAILSCALE_SETUP pointed at FUNNEL_DNS_SETUP.md, which does not exist
    Added from the schematics in ~/schematics:
    - MCP604 front end, VBIAS 1.65V, 10M bias, 10k/100n at each ADS pin
    - shor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
2026-08-22 Add A/V instrument design direction
    - isomorphic, not representational: organism phase sets coupling between
    synthesis voices, not pitch
    - rejects voltage-to-pitch and threshold-to-trigger; Physarum has no events
    - build against the synthField frame contract, which already carries phase
    - do not transpose to audio rate as the primary layer
    - light and sound are stimuli; instrument must not run during experiment windows
    - names the two artifacts and which one the paper is about
2026-08-26 Consolidate docs to a single STATUS.md
    - STATUS.md is the only current-state doc; plain-language summary, evidence
    term definitions, channel map, established/not established, next steps
    - PICKUP.md and both session files moved to documentation/archive/
    - hardware_setup.md channel map corrected against Board A rows: ch0 r38L
    orange, ch1 r40L blue, ch2 r40R green, reference r38R brown
    - nature_brief_20260827.md added for the editor visit
    - method_basis.md and rebuild_plan.md brought under version control
2026-08-26 Draw ch0 orange in the panel
    - ch0 trace follows the Cat6 pair colour, not the ADS lead colour
    - #b4560e light, #ef9040 dark
2026-08-26 Let the organism set the tempo, and capture the model's uncertainty
    Two systems entrain each other without either one knowing anything about the
    other -- the earth and the moon are locked and neither represents the other.
    What entrainment needs is a two-way causal path, not mutual awareness. So the
    asymmetry between the model and the plasmodium does not rule out real coupling;
    it means the coupling has to be in the timing.
    On a fixed tick it was not. The model chose the zone, but the rhythm of the
    exchange was ours, which makes a driver with a model attached rather than a
    loop. A metronome wired to a light would entrain a plasmodium the same way.
    Timing is now two-way:
    * turns fire when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
    [app.py]
2026-08-26 Fold the editor briefing into STATUS.md, add the piece description
    Consolidates nature_brief_20260827.md and TAILSCALE_SETUP.md into STATUS.md so
    there is one current-state document rather than three that can disagree.
    description.md is a draft description of the piece and its departure points --
    Uexküll, Tenney via Lamb's The Form of the Spiral, Albers, Krauss and Campus,
    Meadows, Turtle et al. on dis/identificatory coding. Drafted, not yet in its
    final voice.
2026-08-26 Show the phase histogram publicly, keep the counts behind admin
    The admin token lives in AdminPanel's own component state and nowhere else --
    not a cookie, not localStorage, deliberately. So a sibling component cannot
    authenticate, and gating /api/phase-lock on admin meant the panel could never
    appear on the dashboard it was built for. Passing the token around to fix that
    would give up the property the comment in AdminPanel is protecting.
    Public callers now get the histogram normalised to proportions, plus R, the
    null, p and the verdict. n_onsets and samples still require admin.
    The split is where the leak is. A phase distribution says when light landed
    relative to the organism's rhythm an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
    [app.py]
2026-08-26 Record the run 7 blank and the as-built island geometry
    - STATUS: run 7 blank `20260826T191540Z-test`, organism out, fresh blobs,
    electrodes unchanged
    - STATUS: step 7 pre-registration written before any of the run's data was
    read; statistic, decision rule, exclusions, 20 h minimum
    - STATUS: protocol table through step 8; run 6 closed 2026-08-26 21:15
    - hardware_setup: island geometry as built 2026-08-24, dimensions and spacing;
    continuous bed marked superseded with both faults it had
    - hardware_setup: matrix unplugged after a condensation short, IR flood
    confirmed fitted
    - rebuild_plan.md moved to archive/, superseded by the STATUS protocol table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
2026-08-27 Separate slime-attributable signal from the rest, and sonify it
    - processing/slime.py: shared chain. Gate = per-sample noise AND 90-200 s
    spectral excess, plus hysteresis and a minimum run. 0% false positives over
    22.3 h of blank; recovers ch1's connected period as 38.6 h against a 38.7 h
    truth from the timelapse.
    - slide_dex vectorised across windows: 7.5x faster, bit-identical. Per-window
    medians were 91% of runtime, nearly all numpy call overhead.
    - WARMUP is WIN + TAU + MIN_RUN. At WIN + TAU a 300 s window left 900 s of
    usable record against a 3600 s minimum, so short windows could never gate.
    - /api/readings/processed serves the chain bucketed, reading WARMUP before the
    requ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
    [app.py]
2026-08-27 Write up the A/V instrument build and the open PLL question
    - where /drift lives, what is modelled, how to test the worklet in Node
    - three bench hypotheses from the component values, all unverified on hardware
    - the lock-detect measurements: no C1 tested both clears 0.66 and returns
    under 0.32, so the mux stays latched on osc1
    - sound decisions with the measurement behind each, including the 220k mixer
    resistor that translates to the board
    Claude-Session: https://claude.ai/code/session_013bU8ec3oiC4KTvU88fJUAZ
2026-09-01 Record the run 7 / run 8 result
    - Blank 14 h: no hour on any channel clears p 0.01 in the 60-200 s band
    - Organism 21 h: ch0 19/21 hours at +1.64 to +3.22 dex, 120-164 s; ch1 9/21
    - After removal: nothing, but at 0.016 mV per sample it is a dry input, not a blank
    - Score the step 7 pre-registration against its own decision rule
    - Current state: dish out since 08-29 00:00, record paused 08-29 to 09-01
    - Estimator is a re-implementation; absolute dex not comparable to run 6 figures
2026-09-01 Add a sound log panel to /drift, and a pulse when a pin connects
    - SOUND LOG button toggles a plain-language panel with a live status list
    - Gate 0->1 blooms yellow at that oscillator's source, once, 1.8 s
    - Pace and looping now come from one place, so a bundled recording can use them
    - Document the URL parameters, the drive formula and the request resolution
2026-09-01 Package the piece as a standalone object
    - export_replay.py freezes a window through the signal chain to JSON
    - Drift.vue plays replay.json when present, API when not; shape decides
    - exhibit/: 27.9 h of run 8, static server with history fallback, build script
    - Kiosk unit, systemd unit, and the Pi setup in documentation/exhibit_object.md
    - object/ is build output and stays out of git
2026-09-02 Make /drift work on the object's touch screen
    The exhibition object gets a touch panel, so the page now behaves differently
    when it is the object than when it is the website. It decides which from the
    presence of the bundled recording -- the thing that is actually true about the
    object -- rather than a flag on the kiosk URL that could be left off. ?kiosk=1
    forces it for previewing on a laptop.
    Three of the differences are load-bearing:
    - A tap on the field no longer toggles fullscreen. Under kiosk the object is
    already fullscreen, so the only thing a stray tap could do is take it out,
    and nothing in the box could put it back.
    - The back-to-dashboard link is not rendered. There is no AP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
2026-09-02 Ship the 06:00-09:00 window instead of the whole of run 8
    The object now plays three hours of 2026-08-28 morning, 06:00 to 09:00 CEST,
    at speed=12 so one pass takes fifteen minutes. Exported with the existing
    export_replay.py against the rig's CSVs, so the signal chain ran once with
    proper warmup rather than the window being sliced out of the old file.
    ch0 is connected for all of it and ch1 for 62.6%, so the loop is the
    two-minute rhythm at its most sustained. What it gives up is the narrative of
    the 27.9 h export: no arrival at 02:08:46 and no silence after removal, since
    the organism is already on both electrodes when the window opens and still
    there when it closes. The old export is rege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
2026-09-02 Write down why speed=12 means different things in the two places
    The window frozen for the object sounded five times slower than the same
    window on the website, at the same ?speed=. advance() steps `speed` array
    indices per second, and the website's array is the API's 2000 buckets (5.4 s
    each for a 3 h window) while the object's is replay.json at 1 Hz. So the
    website was really playing ~65x, and the object plays a true 12x.
    The panel's "N minutes" label is computed as mins/speed, which is right for
    the object and wrong for the website, where it ignores the bucketing.
    12 is the shipped default, chosen after hearing both.
    Cl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
2026-09-02 Park the PLL on a voice that moves
    The right output was a bare square at a fixed pitch for the whole loop. Two
    things were compounding, and only one of them is the known PLL problem.
    The lock detector still never trips -- measured 0.111 to 0.500 against a
    Schmitt that needs 0.66 then 0.32, and 0 clocks over the shipped window. That
    is unchanged and unfixed. Feedback dividers of 2, 4 and 8 do not fix it
    either: the node tracks a control voltage proportional to frequency, so
    clocking needs a 2.06x swing in the tracked voice, and the bank only swings
    2.03x. No divider changes a ratio.
    The audible fault was separate. 4051 Y0 carried osc1, which is modulated only
    by vactrol C, and on this windo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
2026-09-02 Make the mux wiring a setting, and put the default back as built
    8fb781b hard-coded osc2 onto 4051 Y0. That was wrong: it bakes a choice that
    depends on which electrodes one particular run reached into the instrument
    itself, where it would also be wrong for a run 6 window in which ch1 and ch2
    both connect.
    Now ?mux= sets it, defaulting to 0,1,2 -- the board as jumpered. Nothing
    changes for anyone who does not pass it.
    To be explicit about what this is not: ch2 having no connection in run 8 is a
    result, not a fault. The organism did not grow to that electrode. vactrol C's
    drive sits at the free-run floor for the whole export, which is correct and
    unaltered, and no silence is filled in. The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
2026-09-02 Revert the mux change entirely; leave the circuit as jumpered
    Both the hard-coded rewiring in 8fb781b and the ?mux= setting in e2e0b36 are
    out. ring-processor.js and Drift.vue are back to what they were: the 4051
    carries osc1..osc3 in order and there is no knob.
    Which oscillator is worth listening to depends on which electrodes a given run
    reached, and that is not something the instrument should encode. The piece
    reflects what the data does.
    What is kept is the measurement, because it answers a question the notes had
    open. The lock detector needs the tracked voice to swing 0.66/0.32 = 2.06x.
    osc1 swings 1.03x, osc2 2.02x, osc3 2.03x. Dividers of 2, 4 and 8 all give
    0 clocks, because no div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
2026-09-02 Autostart for Raspberry Pi OS Lite
    The object runs Lite, which has no desktop session and so no
    ~/.config/autostart for a .desktop file to live in. drift-kiosk.desktop is
    replaced by drift-kiosk.service, which runs cage on tty1.
    PAMName=login with TTYPath is what gives the unit a real session on seat0;
    without it cage exits with "Could not open target tty: Permission denied".
    XDG_RUNTIME_DIR has to be set explicitly because systemd does not provide it to
    a service, and cage refuses to start without it. Restart=always so an unplug
    brings the piece back rather than leaving a console prompt on the wall.
    The browser is /usr/bin/chromium: trixie's name for it. Bookworm and earlier
    call it chrom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
2026-09-02 Record where the model departs from the schematic
    Checked against schematics/sllm-cmos-stage-schematic.svg. The model is not the
    schematic, and the gaps explain why the PLL work kept dead-ending.
    Y5 is the significant one: the schematic feeds the mux the organism's own
    signal through a unity buffer, and the model ties that input to 0. Y3, Y4 and
    Y6 (the two sub-octave taps and the 4070 XOR) are grounded too, so the mux can
    only ever see the three oscillators. The comparator is PC2 where the schematic
    calls for PC1, and the lock detector taps the loop filter rather than PC1 OUT.
    Retracts the earlier conclusion in this file that the detector cannot trip as
    built: that was measured on this mo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
2026-09-02 Clarify: SLIME is fed by the three electrodes, not the DAC channels
    'Channel' is overloaded in this project -- it means an electrode channel and
    also a DAC output channel. The unity buffer takes the electrodes, ch0/ch1/ch2,
    one op-amp section each.
    Claude-Session: https://claude.ai/code/session_01DKos8maXvjo7cfA3KDY9G3
2026-09-02 Wire the mux and make the PLL hunt, per the schematic
    The 4051's Y3-Y6 were tied to 0 in the model while the schematic wires them,
    so the mux could only ever see the three oscillators. They are not extra
    oscillators: D2 and D4 are OSC1 divided by 2 and 4 (the 4013, or the third
    4040), X12 is the 4070 XOR of OSC1 and OSC2, and Y5 is SLIME -- all three
    measuring electrodes summed through the unity buffer, biased to Vdd/2 and
    squared by the 4046's input comparator. Only Y7 is genuinely n/c.
    The loop comparator is now PC1, the XOR on pin 2, as drawn.
    The lock detector was averaging the VCO control voltage, which is a static DC
    once locked and so could never clock the 4040 -- zero clocks on eve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
2026-09-02 Add a run 6 recording and let build.sh take a second one
    build.sh now takes an optional recording and output directory, so two windows
    can be built from one tree and served on different ports for comparison. The
    page always asks for replay.json, so the file is copied under that name
    whatever it was called going in.
    exhibit/replay_run6.json is 2026-08-26 00:00-03:00 CEST: ch1 and ch2 both
    connected for the whole window, and ch0 not gating at all. That last part
    matters -- ch0 was never colonised in run 6, and the gate produces known false
    positives on it there (signal_processing.md), so a window where it does not
    fire is one where nothing is being sonified that is not an electrode the
    organi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
2026-09-02 Explain the circuit in plain English, and note the schematic is updated
    Walks the five stages: the vactrol-coupled oscillator ring, the passive mixer,
    the 4051, the PLL, and the reconfigure-on-failure loop.
    The last stage is the one worth reading twice. Averaging any node in the loop
    to detect lock fails, because every one of them is a DC once locked -- the VCO
    control voltage and PC1's output alike, PC1's mean sitting at half rail whether
    the loop is holding or wildly off. It takes 4046 pin 1 gating a relaxation
    oscillator: failure makes it run, lock clamps it silent.
    schematics/sllm-cmos-stage-schematic.svg is updated to match -- a PCP OUT (1)
    pin with a net label, the 1M redrawn as feed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
2026-09-02 Note the SLIME buffer gain gap as a known open item
    Confirmed with the user: the electrode buffer is unity gain. At ~1.4 mV against
    a 4046 SIG IN that needs 100-400 mV p-p, Y5 hands the comparator a flat line
    and behaves like the empty input. Recorded rather than fixed -- the piece runs
    without it, because the organism still drives the ring through the vactrols.
    Worth writing down because it fails silently and the model hides it: the
    worklet squares the summed electrode signal with an effectively ideal
    comparator, so software shows Y5 working where hardware would not.
    Claude-Session: https://claude.ai/code/session_01DKos8ma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
2026-09-02 Fix the lock oscillator: one time constant, both directions
    932a430 discharged the lock-detect node ten times faster than it charged. That
    factor was invented, not taken from the circuit. Pin 1 is a pulse train rather
    than a level, and against roughly a 25% duty a 10x pull-down wins every time,
    so the node topped out at 0.487 against a 0.66 threshold and the 4040 never
    clocked on any window. The mux sat on Y0 forever and the right channel was a
    flat tone -- the exact symptom the pin 1 change was supposed to fix.
    Measured after, at speed 12 over 3 h windows:
    run 8 (organism) 0 steps
    run 6 (organism) 8 steps, 2.7/h of record, 5 addresses, node to 0.639
    run 7 blank 0 st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
2026-09-02 Ship 62.5 hours spliced from run 6 and run 8
    The object played a single 3 h window on a 15 minute loop. It now plays 62.5 h
    on a 5.2 hour cycle, so a visitor never hears it repeat and an owner keeps
    finding parts of it.
    Three windows end to end, all with the organism in the dish:
    A 2026-08-24 05:00 - 08-25 00:35 19.6 h silence, ch1 arrives at h+9.4
    B 2026-08-25 06:05 - 08-26 04:00 21.9 h ch1 and ch2 both driving
    C 2026-08-28 03:00 - 08-29 00:00 21.0 h ch0 driving, ch1 in and out
    What is left out, and why. Every window in which the rig was handled: the lid
    off on 08-26 at 04:05, the camera ribbon reseated, both sllm-api restarts.
    Those run several mV against a 1.7 mV base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
2026-09-02 Say "no longer connected" once a pin has been reached and lost
    The panel read "not yet connected" whenever a channel was ungated, which is
    true before a pin is first reached and wrong after it has been reached and
    dropped. On the spliced recording that is most of the loop: ch2 carries the
    piece for twenty-two hours and then falls away, and the panel went on calling
    it "not yet".
    Each channel now carries whether it has been connected at any point in the
    current pass, reset when the loop wraps. Verified against a synthetic window
    with a single gated stretch: "not yet connected" before, the drive line during,
    "no longer connected" after, and back to "not yet connected" on the wrap.
    Co-Authore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
2026-09-02 Make the pin-connect bloom three times faster
    FLASH_MS 1800 -> 600. The bloom fades in and out on a half-sine, so the whole
    event now lasts 600 ms instead of 1.8 s and reads as a blink rather than a
    swell. It is wall-clock timed, so ?speed= does not change it.
    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
2026-09-02 Hide the cursor on the root element, not just the field
    The scoped .field.object rule shipped and applied, but a pointer was still
    visible on the object. .field is only styled once the app has mounted and
    replay.json has resolved, which leaves the root element unstyled until then,
    and nothing stops a pointer being drawn over it.
    Sets cursor: none on <html> as well. isObject is false until the recording
    loads, so it is rechecked every 250 ms for five seconds rather than once at
    mount, and cleared on unmount so the website is unaffected.
    Verified in a browser: html, body and field all compute to cursor: none.
    Claude-Session: https://clau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
2026-09-02 Cap the field at 30 fps
    The field recomputes its whole character grid every frame, one interference
    calculation per cell, which is tens of thousands of them at 1080p. On a Pi 4
    that competes with the audio worklet and comes out as clicking -- the ALSA
    buffer is 32k frames, so underruns there are starvation, not buffer size.
    Halving the frame rate halves that cost. Nothing in the field moves fast enough
    for 60 to read differently from 30: the sources rotate at 0.02 rad/s and the
    ring phase advances at 0.30.
    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
2026-09-02 Replace Math.sin with a table in the field loop
    chromium sat at 100% of a core on the Pi 4 with the frame cap already in, and
    the clicking is the audio worklet being starved -- the ALSA buffer is 32k
    frames, so this is not a buffer problem.
    Math.sin ran three or four times per character, tens of thousands of characters
    a frame. A 4096-entry table costs a multiply, a truncate and a masked index.
    The ramp quantises the field to seven levels, so worst-case table error of
    0.0015 against a level step of 0.29 cannot show, and a screenshot before and
    after is indistinguishable.
    The per-source phases are now reduced mod 2pi once per frame rather than being
    recomputed per character, which is both c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
2026-09-02 Add a one-command deploy for the object
    Pull, build, rsync to /home/chootka/drift, restart both units, then print what
    came back up: unit states, the audio cards ALSA can see, and the stored volume.
    The card list is worth printing every time. HDMI audio was stealing the output
    until vc4-kms-v3d got ,noaudio, and if a second card ever reappears there that
    is what has happened.
    --local skips the pull, for testing a change that is not committed yet.
    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
2026-09-02 Stop allocating in the audio thread
    Sporadic clicking on the object, at a 32k-frame ALSA buffer that could not
    plausibly underrun. pw-top showed Chromium reporting zero errors, so the
    browser was not the problem either -- and Chromium writes straight to ALSA
    here, so pipewire was never in the path.
    The audio loop allocated a fresh array every sample:
    const g = this.vac.map(v => 1 / (R_DARK * Math.pow(R_LIT / R_DARK, v.lum)))
    48000 short-lived arrays a second in the audio thread, plus three Math.pow.
    The collector eventually stops to clean that up, and a stop in the audio thread
    is a click. Sporadic, not periodic, which is what was heard.
    Now: a reused array on the processor, an inter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
2026-09-02 Hold the recording in typed arrays, not an object per sample
    The clicking was worst for the first minutes after every start and then
    stopped. That is not a steady fault, it is a startup burst ageing out, and it
    appeared the moment the shipped recording went from 3 hours to 62.5.
    expand() built one object per sample per channel: 675,000 of them for this
    file, against 32,400 for the old one. V8 works through a graph that size for
    minutes, and every major collection pauses the audio thread. Once it settles
    into old space the pauses stop, which is exactly what was heard.
    Three typed arrays per channel instead, indexed directly at the call sites.
    36 MB of object graph becomes 5.8 MB of flat buf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
2026-09-02 Let chromium give its audio thread real-time priority
    Measured rather than guessed. Polling the ALSA stream state while the piece
    played and clicked gave XRUN six times in thirty seconds, with SETUP ->
    PREPARED between them: the audio genuinely drops out, and chromium closes and
    reopens the device to recover. That reopen is what is audible.
    Two supporting measurements. No chromium thread had real-time priority at all
    -- ps -eLo tid,cls,rtprio,comm printed nothing above zero -- and the renderer
    sat at 100% of a core throughout. A normal-priority audio thread against a
    saturated renderer is exactly this failure mode.
    LimitRTPRIO lets chromium's request for a real-time audio thread succeed;
    w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
2026-09-02 Larger character cells, 13 -> 18
    The renderer holds a full core on the Pi 4 and the audio thread stalls long
    enough to underrun a 680 ms buffer, which takes a stall of more than two
    thirds of a second. Cell count goes as 1/size^2, so this is about 1.9x fewer
    characters computed and drawn per frame.
    This changes how the piece looks -- the grain is coarser. Revert the number if
    that is the wrong trade.
    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
2026-09-03 Diagnostic: ?field=off stops the canvas entirely
    Bisecting the clicking. The piece is a renderer holding a full core and an
    audio thread that stalls long enough to underrun a 680 ms buffer. This runs the
    audio with nothing drawn at all.
    Clean means the renderer is starving the audio thread and the fix is on that
    side. Still clicking means the audio path stalls on its own and the renderer
    was never involved -- which would also mean the frame cap, the sin table and
    the cell size change were all beside the point.
    Diagnostic, not a feature.
    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
2026-09-03 Stop chromium talking to the network; drop the dead JIT diagnostic
    --js-flags=--always-turbofan changed nothing, so warmup is not the cause and
    the flag comes out.
    Established by bisection since: with the canvas disabled the machine sits at
    25% CPU and 83% idle and the clicking continues, so it is not CPU contention.
    The renderer, the frame cap, the sin table and the cell size were all beside
    the point. And five minutes of continuous tone straight to the DAC is clean, so
    the chain below chromium is fine. Something inside chromium blocks its audio
    thread for longer than the 680 ms buffer on an idle machine.
    Chromium was registering with Google push services and failing --
    QUOTA_EXCEEDED, DE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
2026-09-03 Ask for playback latency, not interactive
    The AudioContext was created with no options, so it took the default
    latencyHint of "interactive" -- the smallest buffers the system will give,
    because that setting assumes something is responding to input in real time.
    Nothing in this piece is. It is a fixed recording driving a synth, and a second
    of latency would be invisible. "playback" trades latency for large buffers and
    tolerance of scheduling jitter, which is the standard remedy for exactly the
    symptom seen here: intermittent underruns on a machine that is 83% idle.
    This should have been the first thing tried. Everything else eliminated so far
    -- CPU, renderer, buffers at the ALSA level, thr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
2026-09-03 Revert latencyHint: playback, it made the clicking worse
    Second time a larger buffer made it worse -- forcing pipewire's quantum to 4096
    did the same, turning clicks into pulsing dropouts. Underruns do not behave
    that way, so whatever this is, it is not the audio thread failing to keep up
    with a buffer that is too small.
    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
2026-09-03 Diagnostic page: is it our worklet, or is it this browser
    Three sounds, no canvas, no recording, nothing of the piece in it:
    1. a native OscillatorNode -- built-in, runs in C++
    2. a trivial AudioWorklet -- one phase accumulator per sample
    3. a heavy AudioWorklet -- 24 sines per sample, comparable load to the
    piece's three oscillators plus the PLL
    If all three click, it is chromium on this machine and our code was never the
    problem. If 1 is clean and 2 or 3 click, the fault is in AudioWorklet
    scheduling. If only 3 clicks, the worklet is too expensive here and the answer
    is to make it cheaper or move it out of the browser.
    Diagnostic, not part of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
2026-09-03 Audio isolation ladder, four cases
    Replaces the three-button version with a ladder that separates every variable:
    1 native OscillatorNode no JS in the audio path at all
    2 worklet, zeros, no messages worklet scheduling alone, pure silence
    3 worklet, zeros + 50ms msgs adds the piece's exact IPC cadence
    4 worklet, heavy math + msgs closest to the piece, audible
    Run each for a minute while polling the ALSA stream state. The first case that
    produces XRUN or SETUP names the cause:
    1 fails -> chromium on this machine, nothing to do with our code
    2 fails -> AudioWorklet scheduling here cannot hold a stream at all
    3 fails -> the 50ms postMessage traffic is what disturb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
2026-09-03 Point chromium at pipewire's pulse socket
    Chromium chooses its audio backend at startup: PulseAudio if it can reach a
    server, otherwise it opens the ALSA hardware directly and holds it
    exclusively. It has been taking the direct path -- pw-top showed the pipewire
    nodes idle while audio played.
    That direct path is the one that fails. Measured: a native OscillatorNode,
    with no JavaScript anywhere in the audio path, drives the stream into
    repeated SETUP and XRUN exactly like the piece does. aplay writing to the same
    DAC is clean for five minutes. So it is chromium's ALSA output specifically,
    not our worklet, not the DSP cost, and not the hardware.
    Removing /etc/asound.conf did not reroute it o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
2026-09-03 Run the audio outside the browser
    Chromium on this Pi cannot hold an audio stream. Measured: a native
    OscillatorNode, with no JavaScript anywhere in the audio path, drives the ALSA
    device into repeated XRUN and SETUP exactly as the piece does. A silent
    worklet does too. aplay writing to the same DAC is clean for five minutes. It
    ignores the ALSA default and PULSE_SERVER and takes the hardware directly, so
    it cannot be moved onto a gentler path.
    So the synth moves out. exhibit/synth/synth.js loads the same
    ring-processor.js against the same replay.json and pipes PCM into aplay, which
    we have proven solid. build.sh drops it beside the worklet in the object, and
    it is never copied -- one file,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
2026-09-03 Feed aplay properly: chunked writes and a real buffer
    aplay reported underruns of 5-70 ms once or twice a second, which is the sound
    coming and going. Three faults in the feeder, all mine:
    - It wrote 128-frame blocks, 512 bytes at a time. Thousands of syscalls a
    second for no reason. Now 32 blocks per write, 85 ms of audio.
    - It rate-limited against a wall clock as well as pipe backpressure, so it
    stopped feeding while the pipe would still have taken more. The pipe and
    aplay's buffer are the correct pacing; the clock check is gone.
    - aplay got no buffer arguments, so it ran on a small default with nothing to
    coast on. Now --buffer-size=32768, which is 680 ms.
    Output unchanged: L rm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
2026-09-03 Sync the visuals to what is being heard, and put the grain back
    Two things.
    The synth generates ahead of the speakers -- it keeps aplay's 680 ms buffer
    full, so a sample computed now is heard about a second later. State was
    broadcast the instant it was computed, so the visuals ran that far ahead of the
    sound, most visibly on the pin-connect flashes.
    Each snapshot is now stamped with its position in the audio and held until that
    audio has actually played. aplay consumes in real time, so seconds played is
    wall-clock seconds since the first write, which makes this self-correcting
    rather than a fixed guess at the latency. Measured: after six seconds the
    stream reports cursor 72, which is exact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
2026-09-03 Bigger buttons, hidden until touched, and recover if the synth stream drops
    Three things.
    The two buttons are much larger on the object -- 260x104 rather than 132x56 --
    and keyed to object mode rather than to @media (pointer: coarse), so the sizing
    does not depend on the panel reporting itself as a touch device. That is not
    something to leave to chance on a sealed object with no other way in.
    They are also out of sight until the screen is touched, and fade again after
    eight seconds, held open while the sound log is up. What hangs on the wall is
    the field and nothing else.
    And the page now recovers if the state stream stops. It kept synth = true after
    an error, which disables its own clock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
2026-09-03 Mute at the mixer, so the lead can be generous again
    I had one number serving two jobs and it could not do both: short enough for
    the button to respond meant too short to keep aplay fed, and the underruns came
    straight back.
    They are separate concerns now.
    The lead goes back to 2 s with aplay's buffer at 32768 frames. A long lead
    costs nothing any more: the visuals stay in step because snapshots are held
    until their audio actually plays, so any stable lead is fine -- it was the
    runaway to 94 s that broke them, not the magnitude.
    And SOUND OFF no longer waits for the queue to drain, because it is not a gain
    change in the audio at all. It mutes the DAC at the mixer, which is instant
    however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
2026-09-03 Give the synth a 10 second lead
    Underruns returned at a 2 s lead and again at 0.5 s, while an unbounded lead
    was clean. That is the tell: with a large lead node holds seconds of PCM in its
    own write buffer and libuv drains it into the pipe on OS events, independent of
    whether this process's timer fires on time. With a short one, feeding depends
    on setInterval running promptly, and any event-loop stall starves aplay.
    A long lead costs nothing now that the other two problems are fixed
    separately. Snapshots are held until their audio plays, so the visuals stay in
    step at any stable lead. SOUND OFF mutes at the mixer, so it is instant however
    much audio is committed.
    The bound is only there to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
2026-09-03 Back to the feeding that measured clean, and stop allocating per block
    aplay fed by cat through a pipe: zero underruns over two minutes. So pipes,
    aplay and the DAC are all fine, and it is this process stalling.
    Two changes.
    The wall-clock bound goes. Every build with one has underrun -- 0.5 s, 2 s and
    10 s alike -- while the build without ran eleven minutes clean. I do not have a
    mechanism for that and will not invent one; this is the configuration that
    measured well. It stays only for --dry, where there is no pipe to push back.
    And process() was being called as p.process([], outs, {}): two fresh objects
    every 128 samples, hundreds a second, all garbage in the one process that must
    not s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
2026-09-03 Make the sound button work even before the state stream connects
    The button did nothing at all. Two reasons, both mine.
    The page only sent the request when `synth` was true, which is set by the
    state stream. If the stream had not connected, or had dropped and the watchdog
    had cleared the flag, the button silently fell through to the in-page worklet
    -- and since the synth had muted the DAC at startup, that fallback was
    inaudible too. So: nothing, with no error. It now always asks the synth first
    and only falls back if that request actually fails.
    And the synth no longer starts muted. A sealed object that arrives silent and
    depends on a single request working in order to ever make a sound ha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
2026-09-03 Soften the button press feedback
    A full white fill on :active reads as a flash against a field this dark. It was
    there because :hover never fires on glass and a finger needs some confirmation
    the tap landed, but the cure was worse. A faint tint and a brighter border do
    the same job without the strobe.
    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
2026-09-03 Send the sound flag live, not on the delayed timeline
    The button toggled and then flipped straight back. Snapshots are held about a
    second so the visuals stay in step with the audio, and `sound` was riding along
    with them -- so a snapshot captured before the tap arrived just after it and
    overwrote the label.
    Everything else in a snapshot describes a moment in the audio and belongs on
    that delay. `sound` is the current state of a control and belongs off it.
    Verified: toggling reports false and true on the stream immediately.
    That is the third way I have broken this button. First it was gated on a state
    stream that might not be connected, so it silently did nothing; then the synth
    started m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
2026-09-03 Restore the generation bound, and trim the opening drone
    The wall-clock bound comes back. Measured without it: aplay.stdin.write() keeps
    returning true, so backpressure does not pace this at all -- generation ran at
    twice realtime and the lead climbed a second per second, 30 s to 150 s, until
    the state queue hit its cap. At that point the snapshots matching what was
    audible got discarded and the visuals jumped ahead. That is the sync loss.
    The bound looked like it caused underruns when I first added it. It did not:
    those were two objects allocated per 128 samples, found later. I removed the
    bound and fixed the allocation in the wrong order, so each appeared to be the
    other's cu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
2026-09-03 Label the second button ABOUT
    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
2026-09-03 Give aplay a 2.7 second buffer
    With the generation bound in place, feeding depends on this process's timer
    firing on schedule, and aplay starves whenever it is late by more than its own
    buffer. At 680 ms that happened often enough to be audible.
    131072 frames is 2.7 s to coast on. The only cost is latency, and nothing in
    this piece is interactive -- the sound button mutes at the mixer, which is
    independent of anything queued.
    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
2026-09-03 Even out the writes: 21 ms chunks rather than 85 ms
    Underruns arrived on a regular five-second cycle -- 04:26:09, :14, :19, :24,
    :30, :35, :40 -- rather than at random. Regular means bursty rather than
    overloaded.
    At 32 blocks a write was 85 ms of audio and the pump ran several back to back
    to catch up, so the feed came in clumps. 8 blocks is 21 ms, just over one 20 ms
    tick, so steady state is one write per tick and the feed is even.
    The 2.7 s aplay buffer already cut underruns from one or two a second to one
    every five seconds. This addresses what is left.
    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
2026-09-03 Pace generation by queue depth, not by the system clock
    The interval between underruns scaled with buffer size: one a second at 680 ms,
    one every five seconds at 2.7 s. That is a slow drain, not a stall -- and both
    processes are SCHED_FIFO, the buffer is genuinely 131072 frames, and the synth
    generates at 150x realtime, so nothing was ever late.
    The cause is pacing by Date.now(). The system clock and the DAC's crystal are
    not the same rate and the DAC wins: producing 48000 samples per second of
    system time is slightly less than it consumes, so the buffer drained until it
    ran dry, again and again.
    Pacing on aplay.stdin.writableLength instead lets the consumer set the rate,
    whatever its crys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
2026-09-03 About panel: larger type, wider, more transparent, and two sentences out
    Type up from 0.86rem to 1.15rem and the panel out to 1100px, since it is being
    read at arm's length on a wall rather than on a laptop. Background down to 62%
    opacity so the field still reads behind it.
    "jelly" becomes "gel". Drops "It has been doing this for days" and the sentence
    beginning "Nothing here is sped-up recordings".
    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
2026-09-03 Report the actual byte rate to aplay
    inflight sits at exactly 10 s, which means writes are paced by aplay's real
    consumption, while `generated` outruns the wall clock at 2x. Both cannot be
    true. Either aplay is consuming at double rate -- in which case the audio plays
    twice as fast and this is a format problem -- or `generated` is counted twice
    somewhere and the fault is my accounting.
    192000 bytes a second is realtime for 48 kHz stereo 16-bit. The diagnostic now
    prints what is actually being handed over, which distinguishes the two without
    further guessing.
    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
2026-09-03 Record the DAC overlay: hifiberry-dacplus, not -pro
    The board is an Innomaker PCM5122 HAT with no onboard master crystals. The
    -pro overlay says it has them and makes the Pi the clock slave, and the codec
    then runs at exactly twice the rate it reports -- confirmed by timing ten
    seconds of silence through aplay, which came back in 5.09 s.
    That one setting caused both the octave-high pitch and the desync: aplay drained
    the synth at 2x realtime, so generated audio outran the wall clock a second per
    second until the state timeline hit its 4000-entry cap and started discarding
    the snapshots that matched audible audio.
    Also drops the claim that the panel describes the left/right split, since tha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
2026-09-03 Correct the overlay claim: cause of the 2x drain is still unknown
    Swapping hifiberry-dacplus-pro for hifiberry-dacplus gave an identical 5.09 s
    on the timing test, so the overlay is not the cause and the onboard-crystal
    reasoning in f0c1011 was wrong.
    Keeps what is actually measured -- the card drains at roughly twice realtime,
    confirmed both by timing a known-length file and by the synth's own byte
    counter -- and records it as open, with the two checks that have not been done
    yet: reading hw_params while the device is open, and whether aplay returns
    before draining.
    Claude-Session: https://claude.ai/code/session_01DKos8maXvjo7cfA3KDY9G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
2026-09-03 Settle the overlay from the board spec: -pro is correct
    The Innomaker PCM5122 HAT listing specifies dual oscillators, so the board is
    clock master and hifiberry-dacplus-pro is the right overlay for it. Records
    that as a hardware fact rather than something inferred, and keeps it separate
    from the 2x drain, which measures identically under either overlay.
    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
2026-09-03 Narrow the 2x drain to the card; fix the amixer card number
    hw:0,0 times identically to plughw:0,0, so no ALSA conversion layer is
    involved. No HAT EEPROM exists, and the half-second buffer is far too small to
    explain a five-second discrepancy. What is left is the codec clock.
    The driver names itself "DAC+ Pro" even on the plain overlay, so it detects the
    Pro variant and takes the board as clock master, dividing HiFiBerry's crystals.
    A doubled crystal pair on the Innomaker board would give exactly this.
    Also corrects the volume command to card 0. The DAC is the only card on the
    object now that HDMI and onboard audio are disabled; -c 2 dated from before
    that.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
2026-09-03 Fix the DAC clock: hifiberry-dacplus-std
    The card was playing everything at exactly double rate. The driver auto-detects
    the board's dual oscillators, takes it as clock master, and divides HiFiBerry's
    22.5792/24.576 MHz crystals; Innomaker fitted a different pair, so a divider
    programmed for 48000 emitted 96000. hw_params reported 48000 the whole time, so
    nothing above the card could see it.
    -std forces the Pi to supply the clock. Ten seconds of silence now takes 10.148 s
    where it took 5.094 s, and aplay -l reports "HiFiBerry DAC+" rather than
    "DAC+ Pro" -- that string is the check. Plain hifiberry-dacplus is not
    sufficient; it auto-detects Pro as well, which is why swapping to it earlier
    c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
2026-09-03 About panel: drop the ring sentence, name the electrodes, larger type
    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
2026-09-03 About panel: cut the repeated two-minute rhythm, tighten the wording
    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
2026-09-03 Track playback position by bytes drained, not by the clock
    lead climbed steadily under every configuration because playback position was
    estimated as wall-clock seconds since the first write, which assumes the DAC
    runs at exactly 48000. It does not: 100% fast before the overlay fix, a few
    percent off after, and the standalone aplay timing and the synth's own byte
    counter disagree about even the sign. Any clock-based estimate accumulates
    error until the timeline hits its cap and the snapshots matching audible audio
    get discarded -- which is what broke sync.
    Deriving the position from bytes aplay has actually swallowed self-corrects
    against the real hardware rate. What is left is a constant o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
2026-09-03 Sit the piece back to a bed until the organism makes contact
    With no pin connected there is no bio signal, only the oscillators idling, and
    hours of that at full level is wearing to listen to. The master level now rests
    at a quarter and swells forward as the vactrol drive rises, so a connection
    foregrounds itself out of the bed the way the signal foregrounds itself out of
    the noise the electrodes pick up.
    Keyed to the coupling drive rather than to any particular pin or window, so it
    follows whatever the data does. Smoothed per sample over six seconds: a step in
    master level would be a click, and this piece has had enough of those.
    REST_LEVEL and SWELL_KNEE are the two numbers to set by ear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
2026-09-03 Smaller buttons, larger labels
    The label was swimming inside the target. Still well over the 56px a finger
    needs.
    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
2026-09-03 Log played against the oldest snapshot held
    The state stream wedged on a single snapshot: one distinct `at` across five
    seconds of curl, which is why the visuals never left drift mode. Either
    playback position stopped advancing, or it sits behind the oldest entry the
    timeline still holds, in which case the release loop can never get past entry
    zero. These three numbers separate the two.
    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
2026-09-03 Cut audio latency from 13 s back to under 2 s
    The ten-second in-flight queue and the 2.7 s aplay buffer were both put in to
    survive the underruns a DAC running at double rate was causing. They worked,
    at the cost of thirteen seconds between a sample being computed and heard.
    The wall-clock position estimate hid that: it released state as soon as it was
    generated, so the visuals ran thirteen seconds ahead of the sound and the error
    was invisible against a slowly drifting field. Deriving position from drained
    bytes made the delay honest, and honest looked broken -- state now correctly
    lagged generation by the full buffer.
    With the clock fixed the cushion is not needed. One second in flight a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
2026-09-03 Smooth the playback position so the field moves instead of jumping
    Playback position is derived from how much audio is queued in Node, and that
    depth sweeps the full queue as the pump fills to the cap and coasts down. With
    a ten-second cap it sat pinned at the ceiling; cutting it to one second exposed
    the sawtooth, and feeding that into the release index made the rings jump from
    size to size rather than moving through the states between.
    A ~0.7 s one-pole follows the real rate and ignores the sawtooth, plus a clamp
    so the visuals never step backwards -- rewinding reads much worse than being
    slightly late.
    Claude-Session: https://claude.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
2026-09-03 Measure the ALSA delay instead of assuming it, and stop the filter lagging
    ALSA publishes exactly how many frames are still to be played. Reading it four
    times a second replaces the assumed --buffer-size constant with a measurement:
    on the object it reads 29856 frames, 0.62 s, against the 0.68 s assumed. Total
    latency now prints in the log so A/V sync is a number rather than a judgement.
    Also fixes the smoothing added in the last commit. A one-pole tracking a value
    that rises a second per second sits behind it by its own time constant, so the
    filter itself was costing ~0.7 s of lag. Adding TAU back cancels it, and the
    filter is time-based now so the emitter's rate cannot change the tuning.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
2026-09-03 Take playback position from hw_ptr: what the card has actually played
    Every version of this so far estimated position by subtracting buffers from
    what had been written, and each round found another term I had missed -- the
    card's ring, then the filter's own lag, and still unaccounted: up to 0.34 s
    sitting in the OS pipe between Node and aplay.
    hw_ptr is the count of frames the DAC has clocked out. That is the playback
    position outright, with nothing to subtract and nothing left to get wrong. It
    advances once per period, so it is interpolated between reads, and the byte
    estimate stays as a fallback if /proc is not readable.
    Claude-Sessio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
2026-09-03 Screen the drone back to a rumble until contact is made
    The contrast is tone rather than level now. With nothing connected the bank is
    rolled off to 150 Hz -- the square wave's upper harmonics, which are what make
    this wearing to sit with for hours, are gone and the body of it stays. Contact
    opens the filter to 9 kHz and the piece steps forward.
    Level still moves but much less than before: rest is 0.55 rather than 0.25,
    because the bed is not meant to be quiet, it is meant to be behind something.
    Two cascaded one-poles per channel, no resonance -- nothing that rings on a
    square edge. Cutoff is exponential in frequency so the sweep sounds even, and
    computed per block, which is far finer tha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
2026-09-03 Two seconds in flight, not one
    lead falls 0.26 s every 30 s: the card plays exactly 30.00 s per interval while
    the generator produces 29.74. At one second of cushion that empties in a couple
    of minutes and underruns. Two seconds buys margin while the 0.87% shortfall is
    tracked down; it is not a fix, and it still costs only ~2.6 s of latency total.
    Not the cause: the pump already runs on a 20 ms timer, so it is not stalling
    waiting for aplay's drain event.
    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
2026-09-03 Screen, not blanket: lift the bed cutoff and let some dry through
    150 Hz with two poles put the speaker under a pillow. 500 Hz plus 15% dry keeps
    the edges legible, so the piece reads as heard from further away rather than
    muffled.
    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
2026-09-03 Drop the bank two octaves while nothing is connected
    The unconnected drone was painful to sit with, and filtering could not fix it:
    what hurts is not the harmonics but the three fundamentals. At 200/204/209 Hz
    they beat at 4-9 Hz, right in the range the ear reads as roughness, and it
    never lets up.
    Two octaves down puts them near 50/51/52 Hz, beating at 1-2 Hz -- a slow swell
    instead of a buzz, and an actual rumble rather than a filtered square. Contact
    glides the bank back up to pitch. On the board this is the timing caps, 47n
    against something four times larger.
    Claude-Session: https://claude.ai/code/session_01DKos8maXvjo7cfA3KDY9G3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
2026-09-03 Take the grit out of the bed: no dry blend, cutoff down to 220 Hz
    Both numbers were tuned when the bank sat at 200 Hz. With it two octaves lower
    the 15% dry signal is raw square edges at 50 Hz -- full bandwidth, and the
    crunch of an engine idling -- while a 500 Hz cutoff passes ten harmonics.
    The dry blend existed to stop the bed sounding muffled when the cutoff was
    below the fundamental. That cannot happen now, so it goes.
    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
2026-09-03 Softer bed: 150 Hz and a little further back
    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
2026-09-03 Measure contact above the free-run floor, not from zero
    With nothing connected the vactrol drive rests at 0.12, not 0, so keying the
    swell off the raw value made "rest" compute a third of the way open: the filter
    at ~590 Hz rather than 150 and the bank 1.3 octaves down rather than 2. The bed
    was never at rest, which is why it stayed thin and gritty no matter how the
    cutoff and level were tuned -- a fundamental near 78 Hz with mid harmonics and
    no body under them.
    Normalised against the free-run floor and depth, the same way the panel already
    reports how hard a pin is pushing.
    Claude-Session: https://claude.ai/code/session_01DKos8maXvjo7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
2026-09-03 Louder overall, with the filter's loss made up and a soft knee on top
    Two separate reasons it was quiet. The filter throws away most of a square's
    energy, so the bed read far quieter than its level said -- that is a loss to
    compensate, not a dynamic, and makeup now rises as the filter closes. And the
    piece ran at 0.25 digital gain, leaving three quarters of the headroom unused.
    Gain to 0.42, rest to 0.60, and a soft knee above 0.8 so the foreground cannot
    clip. Linear below the knee, so the dynamics are untouched and only peaks bend
    -- a tanh across the whole range was tried here before and flattened
    everything, because a square sits at full scale most of the time.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
2026-09-03 Give the bed real material: brown noise, not a filtered square
    No cutoff setting turns a low-passed square into thunder. A filtered square is
    narrowband and dull; thunder is broadband and smooth. They are opposite things,
    which is why every tuning round read as muffled.
    The bed's body is brown noise now -- white through a leaky integrator, so
    energy falls with frequency and it lands as bass rather than hiss -- with the
    filtered oscillators kept underneath at 45% rather than being the whole of it.
    The noise breathes with a slow envelope of the bank, so the rumble still
    follows the beating instead of sitting flat under it. Saturation for thickness,
    since even harmonics read as fat where a squ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
2026-09-03 Fix the noise: it was hiss at 10x gain, not rumble
    The brown-noise filter's coefficients did not sum to one, so it had ten times
    gain and drove the saturator hard -- that was the scrape. The second stage sat
    at 2.7 kHz, which is hiss rather than bass.
    Two proper one-poles at ~90 Hz with explicit makeup, and less drive.
    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
2026-09-03 Take the pad from the capacitor node, not the comparator
    The comparator output is a hard square: instantaneous edges that alias at
    48 kHz, and aliased partials fold down below the cutoff where no filter can
    reach them. That inharmonic metallic content is the scraping, and it is why
    filtering only ever made this duller without making it smoother.
    The capacitor node is the same oscillator without the edges -- it ramps between
    the Schmitt thresholds, a triangle, with almost no high harmonics to alias.
    Three of those detuned against each other is a pad. Square blends back in as
    contact arrives, where the bite belongs.
    With no square harmonics to kill, the bed cutoff comes up from 150 to 420 Hz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
2026-09-03 Calm it down: long vactrol tails, slower swells, quieter PLL
    Too chaotic to sit with. The vactrols were the cause -- 5 ms rise and 50 ms
    fall passed every wobble in the data straight through to pitch. Real LDR
    vactrols decay over hundreds of milliseconds, so 50 ms/600 ms is closer to the
    part as well as calmer: the ring drifts between states instead of twitching.
    Swells stretched to 1.5 s up and 18 s down, the PLL voice pulled back from 0.35
    to 0.18 since its hunting is the most agitated thing in the mix, and the noise
    breathes more gently.
    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
2026-09-03 Less noise, more tone in the bed
    The noise was carrying the bed and the pitched material sat under it, which
    reads as noisy and undefined. Now the pad carries it and the rumble sits
    underneath: definition without edge.
    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
2026-09-03 Drop the noise layer: it was road noise
    Brown noise is what a car on a freeway sounds like, and it fought the pad the
    whole way -- scrapy, then noisy, then freeway. It was my idea about thunder and
    it was the wrong material.
    The bed is the three detuned triangles now, nothing else. Left wired up at zero
    in case a trace sits well under a fuller pad later.
    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
2026-09-03 Bring the level back up now the noise is gone
    The noise layer was carrying more level than the tone was, so removing it took
    most of the volume with it. Gain 0.42 to 0.70, bed makeup 1.9 to 3.6, and a
    little more drive -- which adds level and thickness together, since the pad is
    saturating rather than clipping. The soft knee still catches the peaks.
    Bed makeup only applies as contact falls away, so the foreground is unchanged
    apart from the overall gain.
    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
2026-09-03 Twice as loud, and put the bed on both channels
    Two faults, both mine, found by rendering offline and measuring instead of
    guessing again.
    synth.js posts gain and vco to the worklet at startup, which overwrite the
    constructor -- so every gain and PLL-level change made tonight was discarded
    on load. Those values live in synth.js and are now commented as the ones that
    actually ship.
    And fading the PLL in with contact left the right channel completely silent
    between connections: half the piece missing on a stereo pair, which is most of
    why it sounded quiet. The bed now goes to both channels; the split still means
    something where it matters, with the left keeping the oscillators and the right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
2026-09-03 Warm the field's whites
    The screen read cold against the amber of the pin-connect bloom. Both passes
    move off neutral: blue down most, green a little.
    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
2026-09-03 Put the piece back where speakers can reproduce it
    My "2x louder" was measured wrong: I checked how much energy there was and not
    where it sat. 94% of it was below 60 Hz, so the piece was genuinely twice as
    loud and completely inaudible on anything without a subwoofer.
    Two causes. The bank runs at 35-67 Hz under capScale 2.13, and it was only ever
    audible because a square wave's harmonics reach into the hundreds of Hz -- the
    triangle and the low-pass removed exactly those, leaving a fundamental no
    speaker here can produce. Then I dropped it a further two octaves, to ~25 Hz.
    capScale to 1.0 puts the bank at 75-140 Hz, where a pad belongs, and the extra
    drop is gone. Measured: the dominant p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
2026-09-03 Sound off puts the field in standby
    The piece keeps running in the synth, but nothing drives the picture, so what
    is left is the slow rotation in draw(). Showing the organism's state to an
    empty room with no sound to go with it says nothing; the object rests until
    someone starts it.
    Flashes are suppressed as well -- a pin-connect bloom with silence behind it
    reads as a fault -- but their timestamps are still tracked, so turning the
    sound on does not fire a burst of stale blooms.
    The panel's live readout keeps updating, so ABOUT still tells you what is
    playing. Nothing in the audio path or the sync accounting is touched.
    Claude-Session: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
2026-09-03 Start just before first contact, and make contact a rise not a drop
    The recording opened an hour before the organism first reached an electrode --
    five minutes of drone at speed 12 before anything happens, which is a long time
    to ask of someone standing in front of the object. Trimmed to a five-minute
    lead-in: first contact now arrives 29 seconds in. 53.2 h left, one pass every
    4.4 h. scripts/trim_lead_in.py does it, reading and writing only the derived
    replay file; the original electrode logs are untouched.
    Rendering the opening to check it exposed the gesture running backwards: bed
    makeup, raised earlier while chasing what turned out to be the register
    problem, had made the bed louder tha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
2026-09-03 Bloom picks out the rings, not the whole circle
    The pin-connect flash filled every character inside its radius, which read as a
    solid disc and buried the ripple structure underneath it. Gated to the crests,
    it lights the two or three rings that fall within reach of the pin.
    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
2026-09-03 Bloom travels out from the pin over the length of the swell
    The flash lit all three distance bands at once and faded them together, which
    reads as the circle blinking. Each band now peaks as the wavefront passes
    through it, so the yellow leaves the pin and travels out to the far rings.
    FLASH_MS is 1500 to match SWELL_UP in ring-processor.js, so the picture and the
    sound coming forward are one gesture over the same 1.5 s rather than two
    events that happen to coincide.
    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
2026-09-03 sound-bird: attenuate the landscape, foreground the bird
    First pass at treating the PLL as the subject rather than a fourth voice. It is
    the only thing here that is not part of the landscape: it runs above the bank,
    chases the oscillators without settling, and goes raspy when it hunts.
    The bank ducks to 40% once contact is in, the PLL comes up from 0.18 to 0.55 at
    the host and is scaled again by BIRD, and it gets a dark echo -- two taps off
    one line at 380 ms with a low-pass in the feedback, so each pass is duller than
    the last and the tail recedes. The second tap is offset, which puts it in a
    space rather than beside the speaker.
    Departs from the circuit deliberately: there is no delay li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
2026-09-03 sound-bird: separate knobs for the body and the edge
    The bank's two halves were blended inside the mixer with no way to hold one and
    pull the other. The capacitor ramp is the body -- the sustained weight
    underneath -- and the comparator is the edge, the hard square on top. They now
    accumulate separately and each has its own level.
    On flags, so they can be tried by ear without editing and redeploying:
    node synth.js --speed 12 --seek 0.02 --tri 1 --sqr 0.25
    Also --gain and --vco. A flag with a missing or unparseable value used to reach
    the worklet as NaN, which propagates through every sample and silences the
    piece with no error anywhere; num() falls back to the default and says so.
    Co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
2026-09-03 sound-bird: the ghost, and the organism driving level as well as pitch
    The distant voice that rises and falls belongs to none of the three
    oscillators: it is the difference between them, an artifact of their beating.
    That is why raising a voice never produced it -- nothing generates it. So it is
    generated: a sine tracking |f0 - f1|, which is real data, being precisely what
    the coupling is doing to the bank at that moment, rendered as a voice instead
    of left as a side effect. A sine, since this is the one thing here that should
    have no edge, folded up while the difference is below hearing, glided rather
    than stepped, and riding the same echo as the bird so it stays far off.
    And amplitude: th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
2026-09-03 sound-bird: ring modulation, the real artifacts rather than a copy
    The far-off sounds are secondary artifacts of the three oscillators
    interacting. Multiplying two signals produces exactly their sum and difference
    frequencies, so this is not an approximation of that effect -- it is the
    effect, taken off the actual oscillators instead of reconstructed from their
    measured frequencies the way the ghost is. All the movement comes free,
    because it is already in the signals.
    Taken from the capacitor ramps rather than the comparators: two squares
    multiplied give a wall of harmonics, two smooth ramps give mostly the sum and
    difference themselves. Rolled off gently, since the sum tones land above
    ev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
2026-09-03 sound-bird: measure each electrode against its own range
    Each electrode wanders over its own small part of the possible range, and that
    part moves over hours. Measuring against a fixed scale threw most of the
    movement away -- 2.2 dB of breathing out of a mapping with 11 dB available.
    Measured against where that electrode has actually been lately, the same data
    gives 4 to 8 dB depending on the passage, and quiet stretches breathe instead
    of going flat.
    The window opens fast and closes slowly, so a new peak counts immediately but
    the range is not left stretched by one old excursion, and it will not expand
    noise into a performance (AMP_MINSPAN). Nothing is invented: only the scale
    changes, and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
2026-09-03 sound-bird: stop the bed collapsing, and give it something moving above it
    Two faults behind "it sounds broken".
    The range expander starts with its window closed, and with nothing connected an
    electrode sits at the bottom of its own range -- so full depth pulled every
    voice down to the 0.05 floor and the bed played 26 dB quieter than intended.
    Measured: bed rms 0.039 where it should be 0.228. Depth now follows contact,
    which is also what it should have been on its own terms: there is nothing to
    breathe with until the organism is pushing.
    And the bed was very nearly a pure 80 Hz tone -- harmonics at 5% of the
    fundamental whatever the cutoff, because a triangle down there simply has
    nothing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
2026-09-03 Flip the object's display 180 degrees
    So the Pi's power cable leaves the bottom of the enclosure and hangs, rather
    than being bent back on itself.
    In the page rather than on the kernel command line: rotate=180 there turns the
    picture but not the touchscreen, and taps would land diagonally opposite with
    nowhere good to put a libinput calibration matrix, since cage reads no config
    file. The browser hit-tests through CSS transforms, so the buttons follow.
    Object mode only -- the dashboard and a laptop preview are unaffected.
    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
2026-09-03 Revert the 180 degree flip on dev
    The flip belongs to the sealed object, where it lets the power cable hang. dev
    and main deploy the dashboard people view at sllm.visceral.systems, which must
    stay upright. It lives on the wysiwyg branch instead.
    This reverts commit 9faade7.
    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
2026-09-04 Take the edge off: an output low-pass at 900 Hz
    The thin buzz over the top is the comparator's odd harmonic series -- 151 Hz
    brings 453, 755 and 1057 with it. Nothing was tempering them: at full contact
    `dry` reaches 1 and the bed filter is bypassed by design, so FC_OPEN never
    applies where the buzz actually is. Measured, changing it from 9000 to 1400
    altered the spectrum not at all.
    Two poles on the output instead, always in circuit. At 900 Hz the 762 Hz
    component drops 40% and everything above 1.5 kHz effectively goes, while the
    151 Hz fundamental loses 3%. On --tone so it can be dialled by ear.
    Claude-Session: https://claude.ai/code/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
2026-09-04 The grating series was the PLL, not the oscillators
    Chased this by measurement rather than by ear. The harsh content is an odd
    harmonic series -- 151 Hz dragging 453, 755 and 1057 with it. Changing the
    bank's triangle/square balance moved it not at all, at any setting, which ruled
    the oscillators out: at contact the bank is ducked to 40% and the PLL carries
    the top of the mix.
    The PLL is a comparator square too, and at contact `dry` reaches 1 so it was
    going out entirely unfiltered. It has its own two-pole now at 400 Hz, low
    enough to actually reach its third harmonic, which a 700 Hz corner cannot.
    Measured across the whole chase: 453 Hz from 0.156 to 0.078 of the fundamental,
    762 from 0.0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
2026-09-04 Move the PLL out of fly register
    A wavering tone between 150 and 220 Hz is a fly in the room -- a housefly's
    wingbeat is about 190 Hz -- and that is where the PLL was sitting. Scaling its
    range to 0.55 puts it near 85 Hz and moves the dominant peak of the whole mix
    from 152 Hz down to 70.
    The bank stays where it is: its fundamental at 70-80 Hz is not the problem, and
    below about 70 Hz these speakers stop reproducing it at all, which is the
    mistake made once already.
    Two corrections from this chase, both mine. The apparent cluster of three tones
    6 Hz apart was spectral leakage -- 5.86 Hz is exactly the bin spacing of an
    8192-point FFT at 48 kHz, so one tone was smeared across three bins and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
2026-09-04 Open the output filter, and put the PLL's filter on a flag
    The 900 Hz output low-pass was fighting the PLL buzzing at 152 Hz. That cause
    was removed when the PLL moved down, so the filter was muffling the piece to
    solve a problem that no longer existed. 4000 Hz is effectively out of the way.
    The PLL's own 400 Hz filter is the next thing dulling it, and for the same
    reason -- set when its harmonics landed in fly range, where now they land at
    255 and 425 Hz and read as presence. On --birdtone so it can be opened by ear.
    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
2026-09-04 High-pass the subsonic sludge at 32 Hz
    Ring modulation of two oscillators a few Hz apart produces a difference tone of
    a few Hz. Measured at 5.9 Hz sitting at 0.034 -- as loud as the music, entirely
    inaudible as pitch, eating headroom and muddying everything above it.
    One pole at 32 Hz, well below the 70-110 Hz the piece lives in. This removes
    content that cannot be heard rather than making a choice about how it sounds,
    so it is not a default being set.
    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
2026-09-05 Make the chosen voicing the default everywhere
    speed 25, cap 0.7, pll 0.5, ring 0.3, tone 4000 -- landed on by ear over a long
    session of A/B on the object.
    The dashboard was not posting the new parameters at all, so ring and amp were
    off there and the register was still at 2.13. It now sends the same voicing, so
    the web piece and the object sound alike. Its gain stays at 0.22: that plays in
    a browser where the visitor sets their own level, while the object's 1.0 is
    calibrated against a DAC and a mixer at 85%.
    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
2026-09-06 Encoded timelapse, lightbox, step 9 protocol
    - scripts/archive_video.py: h264 segments + recent.mp4, thins originals 1-in-10
    only where the encode pays (THIN_RATIO); sllm-video.timer runs it hourly
    - /api/video serves recent.mp4, segments and the frame-time sidecars
    - Dashboard timelapse plays the encoded video instead of scrubbing JPEGs
    - Lightbox on the timelapse and livestream, teleported so there is one player
    - Capture interval 300 -> 120 s
    - scripts/stimulus_run.py + stimulus_backstop.py for step 9
    - STATUS.md: step 9 pre-registration
2026-09-06 Experiments structure, CYCLES prompt, run provenance
    - experiments/: one folder per experiment, electrode wiring under
    experiments/electrodes/, both deployed with the code
    - runs carry `experiment` and `electrodes`; an auto-created run now appends to
    runs.jsonl instead of changing mode with no history entry
    - CYCLES prompt variant: period withheld, model states believed_period_s,
    duration_cycles converts with its estimate, cycle error fed back each turn
    - loop logs believed_period_s, measured_period_s, cycle_error
    - /api/experiments and /api/runs
    [app.py, run.py]
2026-09-06 Record the 2026-09-06 session in STATUS.md
    - Running now: organism in, ch1 bridged, 120 s capture, matrix unplugged
    - ch1 bridge 2026-09-05 and the 106-116 s line, with the estimator caveat
    - Known problems: uncommanded matrix pixels, thinned image archive,
    unrecorded run-mode switch
    - Step 9 row: pre-registered, attempted, stopped before any blue block
2026-09-06 Calibration folder, experiment-driven rig state, drop demo mode
    - experiments/calibration/: electrode-health, noise-floor, blank-vs-organism,
    blue-light-response, each with its result to date
    - experiments.enter() applies the definition before a run starts: recovery
    on/off, test/live, and tags the run with experiment + dish
    - calibration is refused unless it records under test
    - llm/loop.py --experiment supplies prompt and params; explicit flags win and
    the override is logged. Inspections (--check/--dry-run/--replay) change nothing
    - /api/experiments walks the same loader the drivers use
    - demo mode removed: flag, service, unit, admin control, interlocks
    - Frontend spells mould/mold fr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
    [admin.py, app.py, config_template.py]
2026-09-08 Meter the model's budget on the organism's period
    - metered_budget inverted: 130 / period_s, so a faster organism buys
    more context and history. Direction chosen 2026-09-08; the inverse
    made light a reward with no stopping condition
    - DoseLedger caps the loop's light at MAX_DOSE_PER_HOUR intensity-
    seconds over a rolling hour. MAX_STIMULUS_DURATION bounded one
    stimulus and nothing bounded the sum
    - llm/filters/prediction.py scores the model's stated period trend
    against the next measurement, deadbanded at half the FFT bin width
    - METERED prompt: states the metering rule, withholds the light-to-
    period relationship. The inference is what the score measures
    - documentation/metered_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
    [config_template.py]
2026-09-08 System overview for reporting
    - Plain-English account of rig, reduction, model loop, metered
    coupling and A/V, with STATUS.md kept as current-state authority
    - Records the barrier-zone discrepancy between method_basis.md and
    the prompts/matrix code
    Claude-Session: https://claude.ai/code/session_01DNvG2RDZJu81VWNkAweMQC
2026-09-08 Record the sealed replacement matrix
    - Panel fitted and powered 2026-09-08, sealed in a zip-lock bag, leads out
    through a taped slit, no exposed wire. Not yet lit.
    - STATUS: rig state, known issue 5, Next item 0, Deferred updated.
    - STATUS rig state also corrected from run.json: current run is
    20260906T231858Z-live; sllm-demo is gone.
    Claude-Session: https://claude.ai/code/session_01NkWDCn21eEVqZufSAS7ukX
2026-09-08 Document all seven prompt variants in the README
    - Add METERED, CYCLES and NULL, verbatim from llm/filters/prompts.md.
    - Variant table at the top of SYSTEM PROMPTS: what the model is told, what
    the loop changes.
    - Intro corrected; prompts.md named as the source of truth.
    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
2026-09-08 Remove the barrier zone, fix stimulus brightness, whole-dish METERED
    Barrier
    - Zone 2 was held lit to keep the plasmodium off the reference. The organism
    now starts ON the central reference island, so it is gone: BARRIER_ZONE,
    BARRIER_BRIGHTNESS, BARRIER_MIN_RADIUS, BARRIER_PIXELS, lit_pixels(), the
    recovery `barrier` state and the leds `barrier` CLI mode.
    - All nine zones drivable. Nothing is held lit; resting state is a dark panel.
    - recovery.json keeps `dark` as an inert field so the admin path is unchanged.
    - three-radial.json: reference is central under zone 4, per-channel `zone` is
    null and unmeasured.
    Brightness and dose
    - STIMULUS_INTENSITY = 0.50, fixed. The model no longer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
    [adc.py, admin.py, app.py, camera.py, config_template.py, leds.py, matrix_client.py]
2026-09-08 Record the lead order on the run
    - run.py: lead_order on the run record, carried forward across a mode change,
    and a change of order starts a new run like a change of dish does.
    - admin POST /run accepts lead_order; omitted carries forward, [] clears.
    - Per-run because the dish is rewired between runs: putting it in
    electrodes/<name>.json would reinterpret every past run naming that file.
    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
2026-09-08 Fix UnboundLocalError when --experiment is given
    - The run.json fallback re-imported run as run_state inside an if block in
    main(), making the name local to the whole function and unbound on every
    path that skips the branch.
    - Passing --experiment took that path, so the first turn died at
    run_state.current(). The service passes no arguments and was unaffected.
    - Module-level import at line 84 is the only one now.
    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
2026-09-09 Raise the whole-dish exposure cap to 180 s/hour
    - Was 30, set while it was unclear the plasmodium had survived handling.
    The timelapse now shows it migrating and fanning out across the reference
    island, so the organism-cannot-flee concern that set 30 no longer holds.
    - At ~12 turns/hour, 30 s bought one probe per hour: too few to separate the
    model's own effect from the organism's drift, which is the whole inference.
    180 s buys about four. 5% duty, a twentieth of the step 8 protocol.
    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
    [config_template.py]
2026-09-09 Fan: halve the exchange window, add an over-temperature hold
    - FAN_CYCLE_PERIOD 240 -> 120. Same 60 s burst, so 50% duty not 25%.
    - FAN_TEMP_ON / FAN_TEMP_OFF, 27.0 / 26.5 C. Holds the fan on above the
    threshold until the chamber falls back under, 0.5 C deadband against relay
    chatter. Same shape as the existing humidity override and, like it, can only
    add run time on top of the timed exchange.
    - Chamber reached 27 C with the organism in, and temperature was observed
    falling while the fan ran.
    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
2026-09-09 Reference island is under zone 5, not zone 4
    - Corrects three-radial.json, hardware_setup.md, system_overview.md,
    led_matrix.md and both configs. The "central, under zone 4" wording was
    written 2026-09-08 from the docs, not from the dish.
    - Whether each island falls cleanly inside one zone is recorded as NOT
    established: the third island may overlap zone 5 too. Reported by eye,
    not measured, and marked as such.
    - Per-channel `zone` stays null until it is measured.
    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
    [config_template.py]
2026-09-09 Bridge watcher: start the loop when the organism reaches an oat island
    - scripts/bridge_watch.py. Per-island mean abs difference against a baseline
    frame, brightness normalised, every 5 min.
    - Two guards before it starts anything: above 4x the island's own noise floor
    for 3 consecutive checks, and at least 2x the other oat islands, so
    condensation or a lighting shift cannot trigger it.
    - The reference island is measured and reported but never triggers.
    - Runs as a transient unit (systemd-run --unit=sllm-bridge-watch) so it
    survives logout and is visible to systemctl.
    Claude-Session: https://claude.ai/code/session_01N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
2026-09-09 Record the fan direction and the new cycle
    - The fan blows OUT: extractor, not intake. Chamber runs slightly negative
    while it is on, replacement air drawn through the seams.
    - Cycle 60s in 120s, and the FAN_TEMP_ON/OFF thresholds, were not in the doc.
    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
